bprendie/weazlbook/about.md

# About this We4zLbo0k

## Reader name
Your name or nickname

## If found
Please contact me using the details below.

## Contact
Email or phone (optional)

## Return instructions
Add a safe way to return this reader.

---

Edit this file in a text editor while the reader is connected over USB.
Only include details you want stored on the device. This file is erased by the duress code.
