bprendie/weazlbook/docs/WORK_PLAN.md

# R05 execution record

Preserve the R04 archive and extracted baseline unchanged. R05 is an engineering
prototype until the evidence register is closed; no hardware is known to be connected.

1. Reconcile R04, archive sources, establish tools and measurement gates.
2. Produce parametric enclosure, genuine part joints and fit coupons; check B-reps,
   meshes and interference against component allowances.
3. Implement an offline desktop reference reader and portable state, with hostile
   input and interrupted-save tests. Keep native firmware support separate.
4. Build an ESP-IDF hardware foundation and native PDF feasibility executable.
5. Export and inspect Kobra S1 0.4 mm ABS projects in the installed real slicer.
6. Record exact results, unsupported features and bench/print gates.

User confirmed Kobra S1, 0.4 mm nozzle, proposed ABS and preference for high speed.
ABS brand/flow limit is not yet specified. No automatic multicolor assumed.
