bprendie/weazlbook/WeazlBook_R04_approval.pdf

# weazlbook

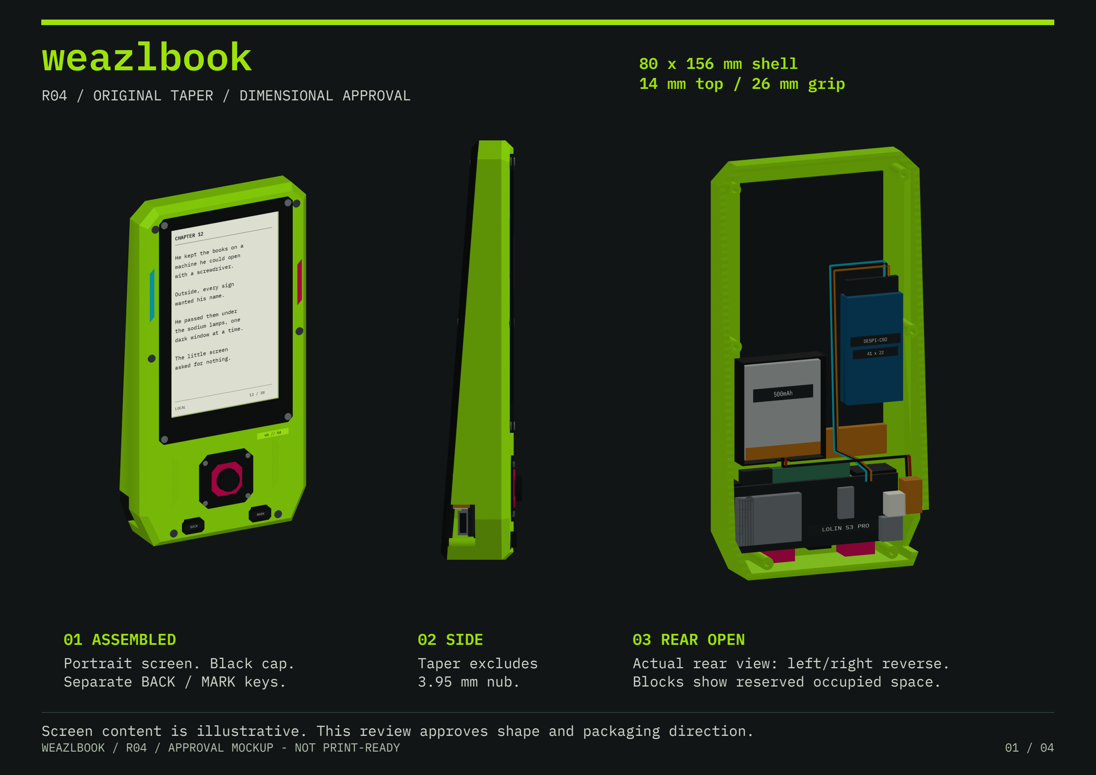
[picture p2: page 1]

R04 / ORIGINAL TAPER / DIMENSIONAL APPROVAL

WEAZLBOOK / R04 / APPROVAL MOCKUP - NOT PRINT-READY | 01 / 04

### 80 x 156 mm shell 14 mm top / 26 mm grip

### 01 ASSEMBLED

Portrait screen. Black cap. Separate BACK / MARK keys.

### 02 SIDE

Taper excludes
3.95 mm nub.

### 03 REAR OPEN

Actual rear view: left/right reverse. Blocks show reserved occupied space.

Screen content is illustrative. This review approves shape and packaging direction.

# SPACE FOR THE HARDWARE

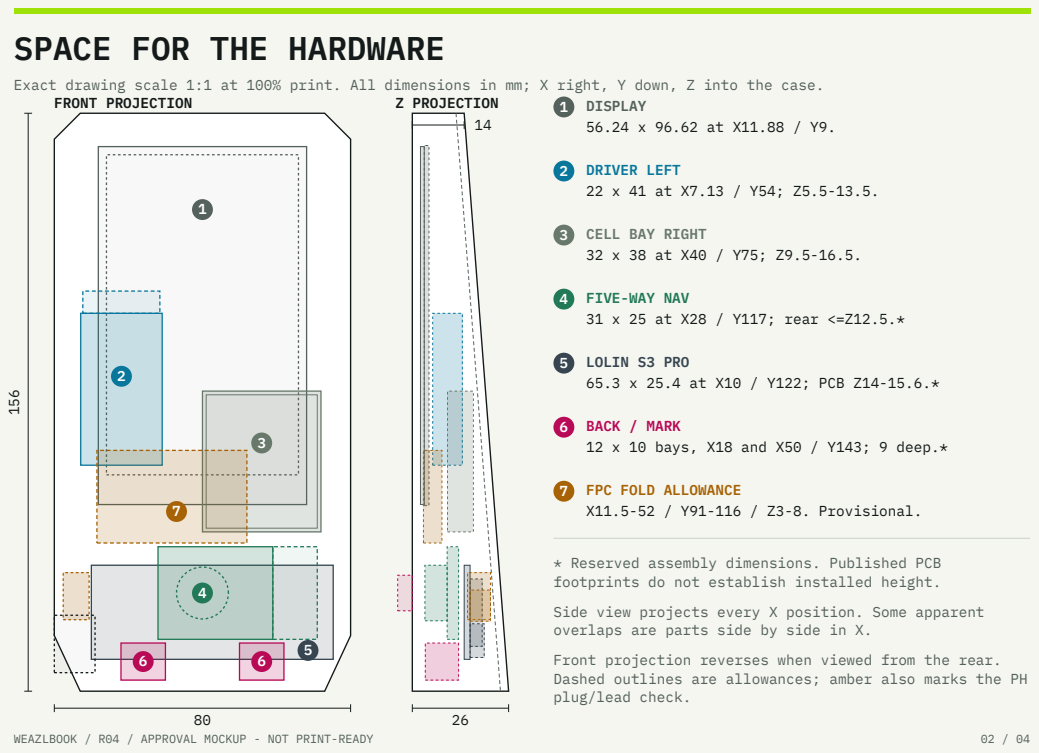
[picture p3: page 2]
FRONT PROJECTION; Z PROJECTION; 1 DISPLAY 56.24 x 96.62 at X11.88 / Y9.; 2 DRIVER LEFT 22 x 41 at X7.13 / Y54; Z5.5-13.5.; 5 LOLIN S3 PRO 65.3 x 25.4 at X10 / Y122; PCB Z14-15.6.*

Exact drawing scale 1:1 at 100% print. All dimensions in mm; X right, Y down, Z into the case.

3 CELL BAY RIGHT

4 FIVE-WAY NAV
31 x 25 at X28 / Y117; rear <=Z12.5.*

6 BACK / MARK
12 x 10 bays, X18 and X50 / Y143; 9 deep.*

7 FPC FOLD ALLOWANCE
X11.5-52 / Y91-116 / Z3-8. Provisional.

* Reserved assembly dimensions. Published PCB
footprints do not establish installed height.
Side view projects every X position. Some apparent
overlaps are parts side by side in X.
Front projection reverses when viewed from the rear.
Dashed outlines are allowances; amber also marks the PH
plug/lead check.

# PUBLISHED PARTS / RESERVED SPACE

Source links are attached to each part name. Full manufacturer geometry and measured assemblies remain distinct.

PART / SOURCE | PUBLISHED | R04 PACKAGING ALLOWANCE
1 DISPLAY GDEY0397T81P > (https://www.good-display.com/product/613.html) | 56.24 x 96.62 x 0.92 Tolerance: +/-0.2/0.2/0.1 | Glass Z2.2-3.22 includes upper tolerance. A separate insulation space sits behind.
2 DRIVER DESPI-C02 > (https://www.good-display.com/product/516.html) | 41 x 22 PCB. 24-pin FPC; 3.3 V SPI. | 8 mm full-depth space, Z5.5-13.5. 6 mm header projection; height unmeasured.
3 BATTERY Adafruit #1578 > (https://www.adafruit.com/product/1578) | 29 x 36 x 4.75 catalog. Protected 500 mAh cell. | Cell envelope 30 x 36 x 6; bay 32 x 38 x 7. Retain factory leads.
4 NAV MODULE EC Buying / Amazon > (https://www.amazon.com/dp/B0D8T4YQ3Y) | 31 x 25 PCB; holes 3 dia. Stem location photo-derived. | Rear limit Z12.5 is provisional. 12 mm for side header and wiring.
5 MAINBOARD LOLIN S3 PRO > (https://www.wemos.cc/en/latest/s3/s3_pro.html) | 65.3 x 25.4 PCB. USB + microSD onboard. | PCB Z14-15.6; local connectors to Z21.1. Port/plug shapes are simplified allowances.
6 TWO TACTILES Omron B3F-1000 > (https://components.omron.com/us-en/datasheet_pdf/A070-E1.pdf) | 6 x 6 x 4.3 each. 7.7 lead-inclusive width. | Each installed bay 12 x 10 x 9. Printed keys and guides above the switches.
CAP + ADAPTER Sprintek 109-00060 > (https://store.sprintek.com/category/flexpoint-pointing-stick) | Fits 2.4 mm square or 3.15 mm round Sprintek stem. | Shown cap dia.9.6 x 2.3 is provisional. Keep dia.14 sweep; measure adapter/socket.

FPC: 33.66 mm published tail reach. R2 fold and seated-tip Y93 are proposed; the driver carrier
needs insertion-depth adjustment.
PH/JST region reaches Z21.1. Only about 0.2-0.6 mm nominal rear-cover clearance remains locally; this is a measured-fit gate.
Amber blocks are FPC and plug/lead check space. Colored strands show harness corridors, not a final wire count or pinout.
INSIDE COVER

# ONE-TO-ONE PAPER CHECK

Approve hand spacing and profile. The outline is not a drill, cut or production template.
FRONT / 1:1 | SIDE / 1:1

READING AREA
51.84 x 86.40

14

26

3.95
nub

156

80

FOUR MEASUREMENTS TO CLOSE

01 / DISPLAY ASSEMBLY
Delivered GDEY panel suffix; adapter height, slot position and insertion depth; gentle FPC fold with strain relief.

02 / NAV + CAP
Stem and cap socket, installed depth, lateral sweep and select travel. Keep the carrier replaceable.

03 / USB + BATTERY PLUG
Actual housings, cable boot and lead turn together. The left opening is an open recess; the PH check volume is provisional.

04 / CELL + SERVICE
Protected cell thickness and wire exit; rear-cover clearance and rear-only microSD access. Retain factory battery leads.

Print at 100% / Actual Size.
Disable Fit to Page.
Verify this bar measures 50 mm.

50 mm

Short 28 AWG device harness.
No measured runtime or working firmware is represented by this mockup.
