bprendie/weazlbook/artifacts/cad/R05-engineering-review.pdf

# WEAZLBOOK / R05

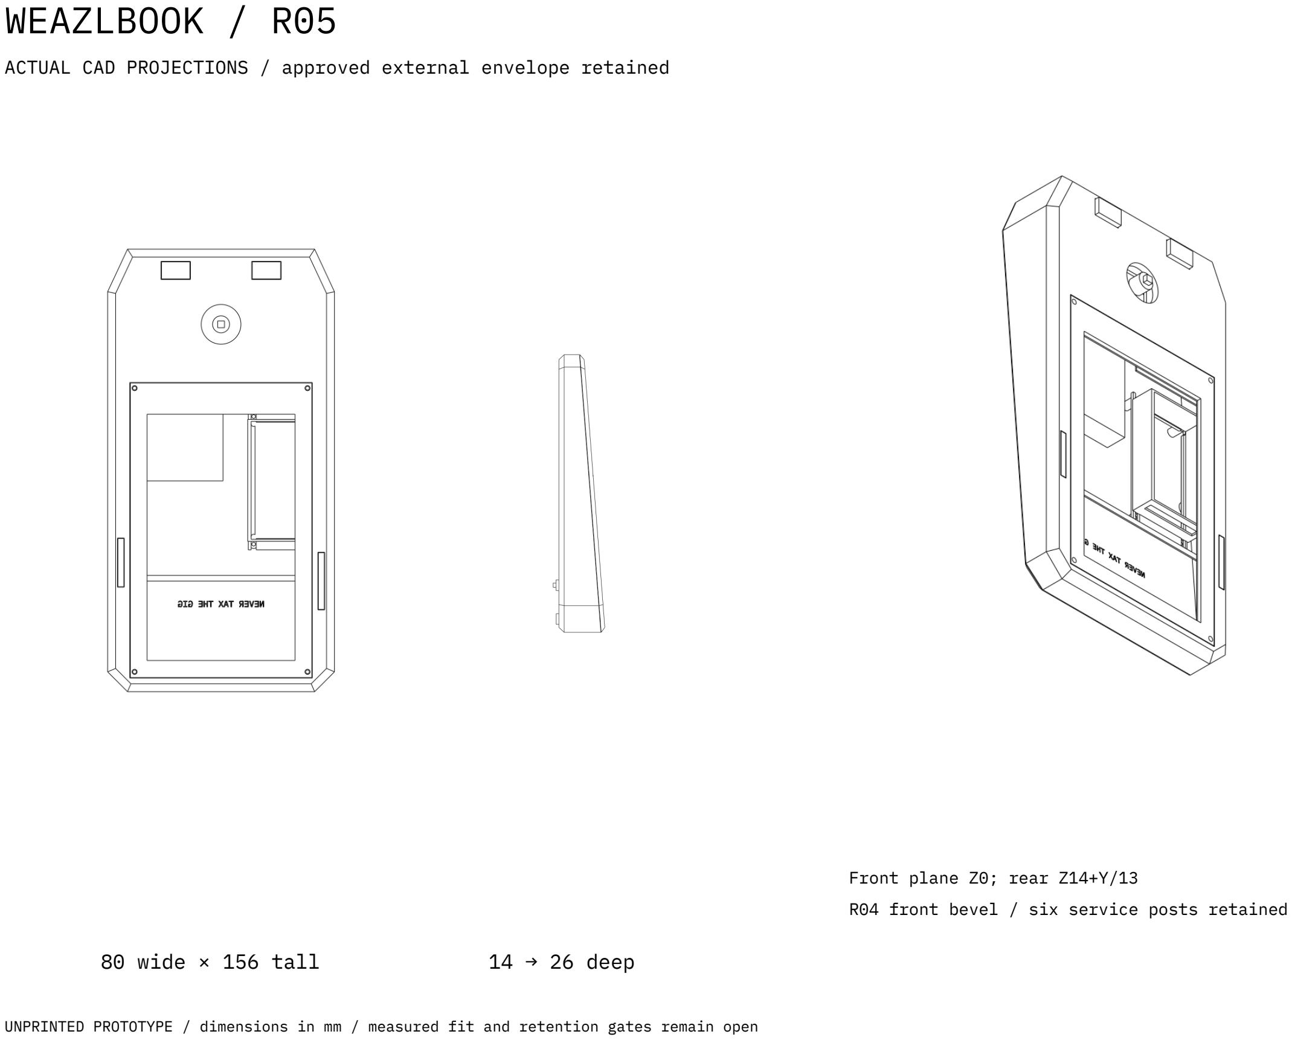
[picture p4: page 1]

ACTUAL CAD PROJECTIONS / approved external envelope retained

UNPRINTED PROTOTYPE / dimensions in mm / measured fit and retention gates remain open

80 wide × 156 tall | 14 → 26 deep

Front plane Z0; rear Z14+Y/13
R04 front bevel / six service posts retained

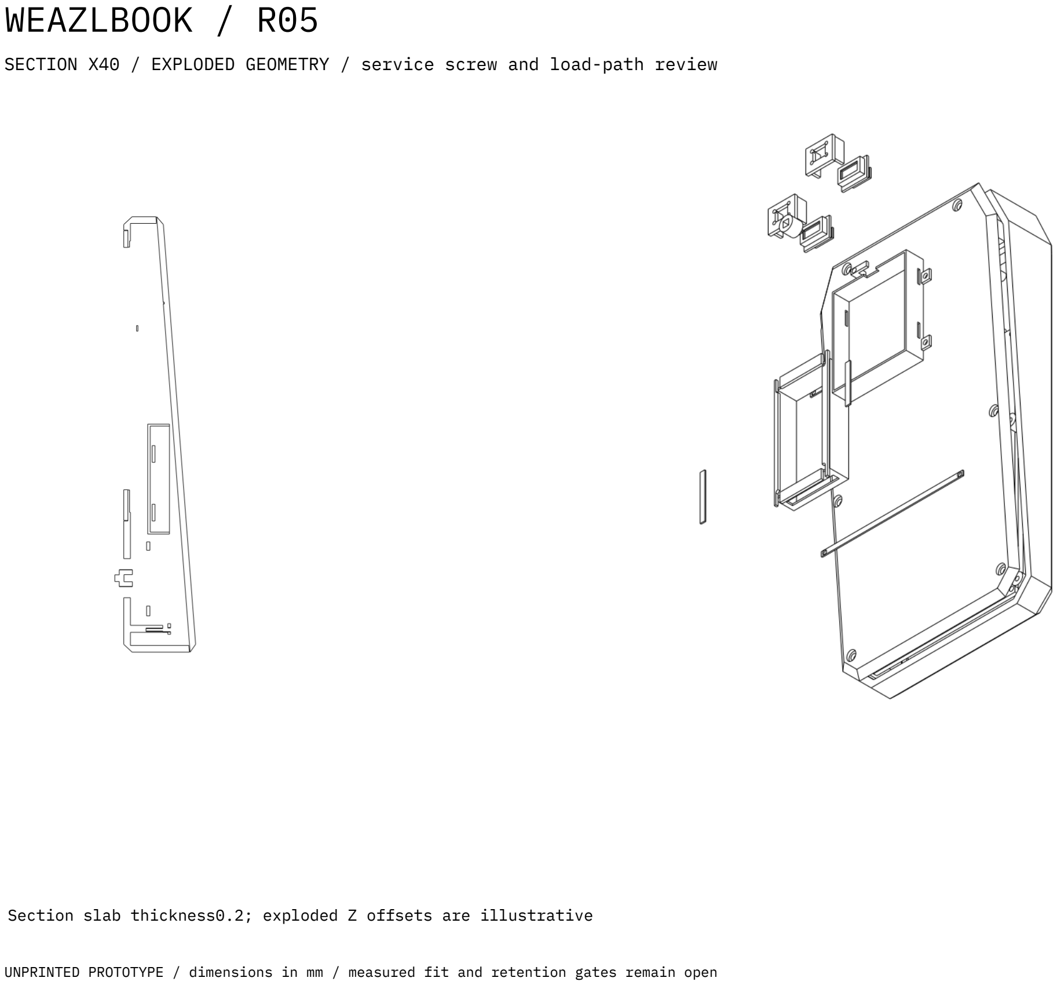
[picture p5: page 2]

SECTION X40 / EXPLODED GEOMETRY / service screw and load-path review

Section slab thickness0.2; exploded Z offsets are illustrative

DIMENSION AND CLEARANCE LEDGER / values computed from R05 sources

Shell outline | 80 × 156; outer octagon preserved
Rear envelope | 14 at Y0;26 at Y156
Glass pocket | 56.84 × 97.22; starts Z2.1
Glass allowance | 56.24 × 96.62 × 1.02
Battery tray rim | Z16.4; nominal plane gap1.115 at Y74.3
Nav rear to PCB | Z12.5 → Z14 =1.5
FPC loop assumption | R2;33.66 length;tipY93;apexY114.998
FPC apex to nav | Y117-114.998 =2.002; bend NOT approved
Battery plug turn | X3.2-2.4 =0.8; real lead turn unresolved
Mainboard clamps | 0.2 nominal shim gap above PCB
Service pilots | diameter1.7;depth7;M2x8 candidate
Key guide / stop | 0.2 per side;0.4 travel;carrier retention OPEN
Part collision volumes | 0 intersections >0.001 mm3
Component block collisions | 0 intersections >0.001 mm3

LOAD PATHS / ASSEMBLY ACCESS / PHYSICAL GATES

Thumb → nav PCB bearing edges → front carrier → columns → chin/frame.

Glass and battery are excluded from the thumb load path.

Display → measured compliant gasket/insulation → bezel/front ledge + bridges.

Battery → tray floor and loose fabric strap → two shell-side tray lugs.

Mainboard → three R04 underlap supports; removable edge clamps retain it.

Rear cover → six M2 service posts. Check engagement and blind-hole floor.

Driver carrier attaches to cover: opening/FPC access must be demonstrated.

Driver Y slots allow ±3 adjustment; seated tail tip is not connector mouth.

Key carrier retention and VBUS sensor mounting remain OPEN CAD gates.

USB cable and PH plug must be inserted simultaneously for fit verification.

No physical battery life, RF, USB-copy or drop-test result is asserted.
