bprendie/weazlbook/artifacts/alice-preview.png

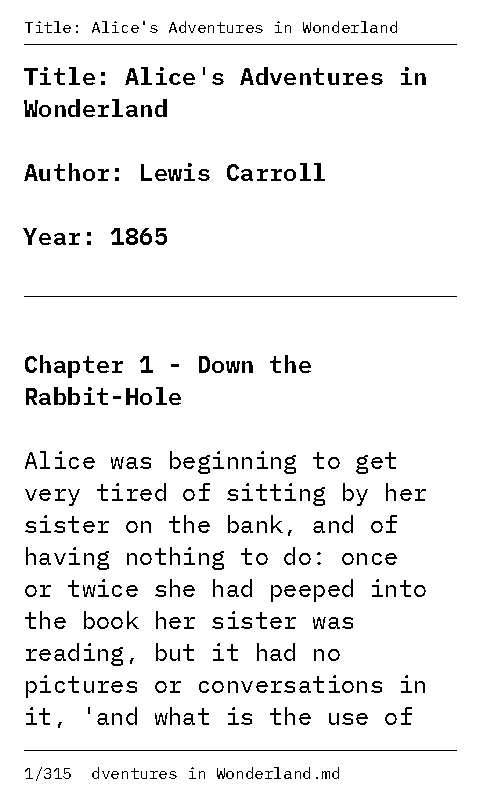
artifacts/alice-preview.png
