bprendie/weazlbook/artifacts/cad/views/exploded.png

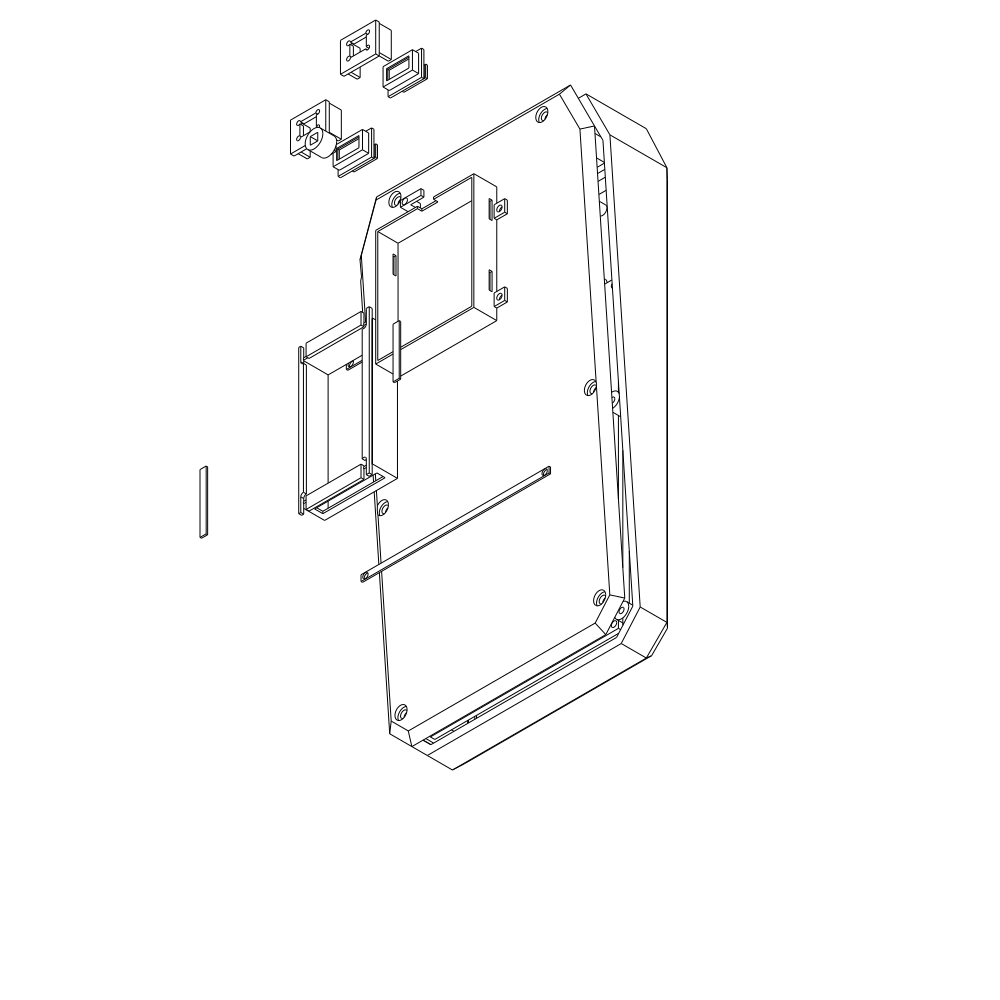
artifacts/cad/views/exploded.png
