bprendie/weazlbook/artifacts/cad/views/front.png

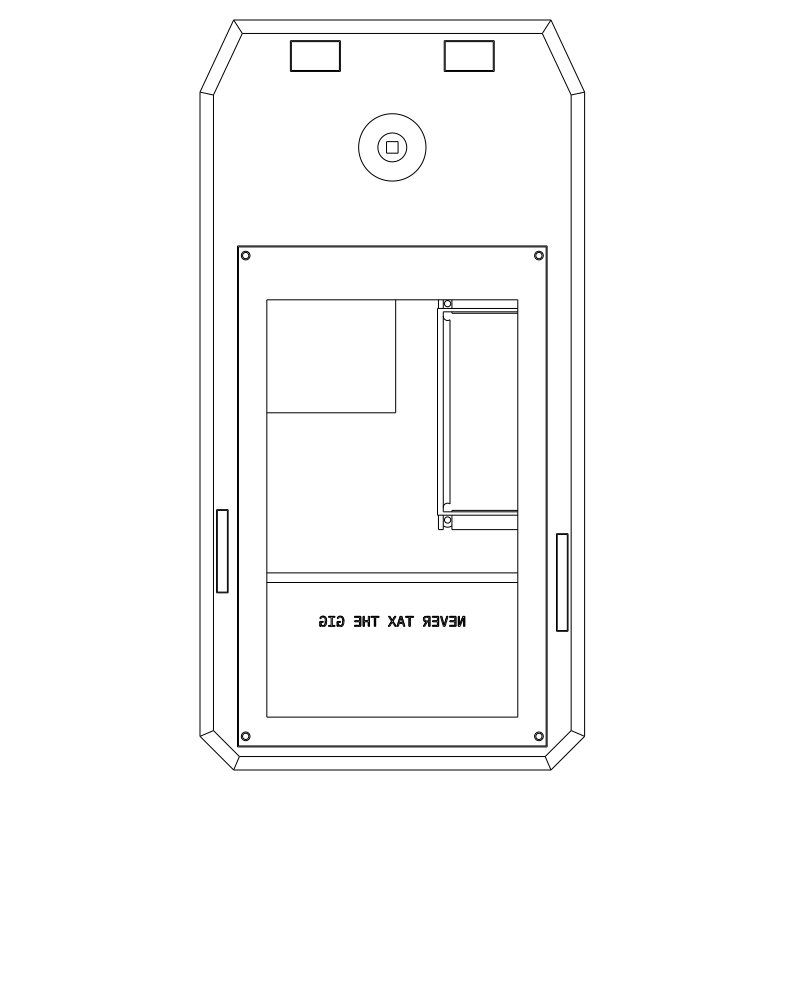
artifacts/cad/views/front.png
