bprendie/weazlbook/artifacts/cad/views/isometric.png

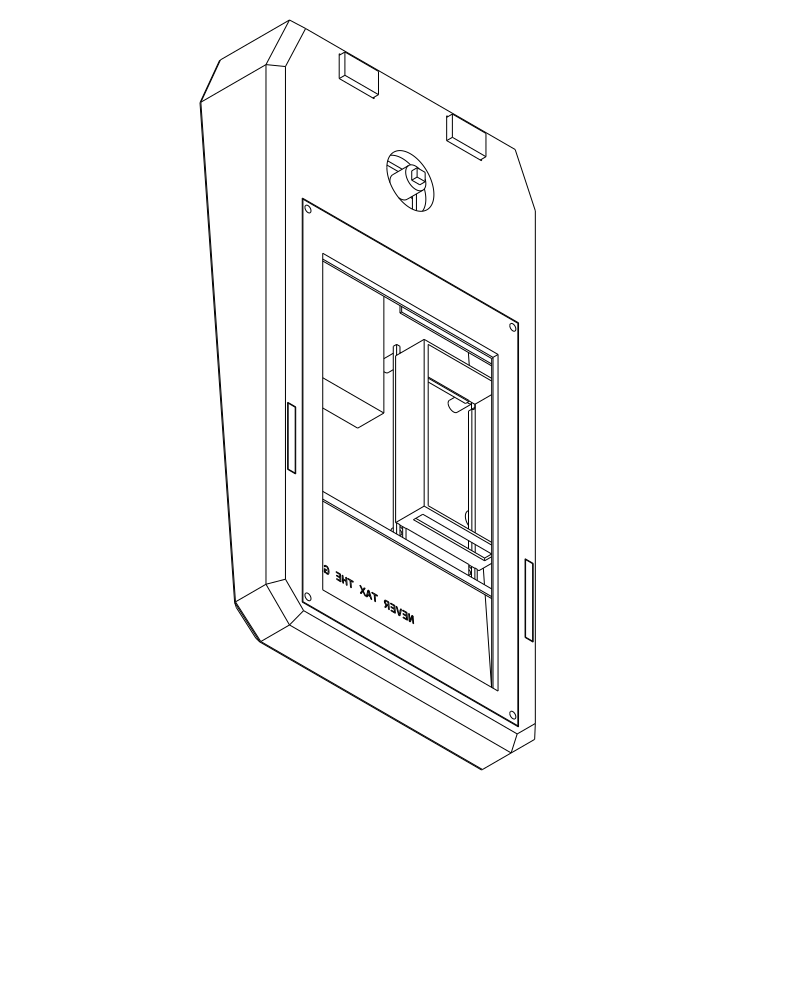
artifacts/cad/views/isometric.png
