bprendie/weazlbook/artifacts/cad/views/section-x40.png

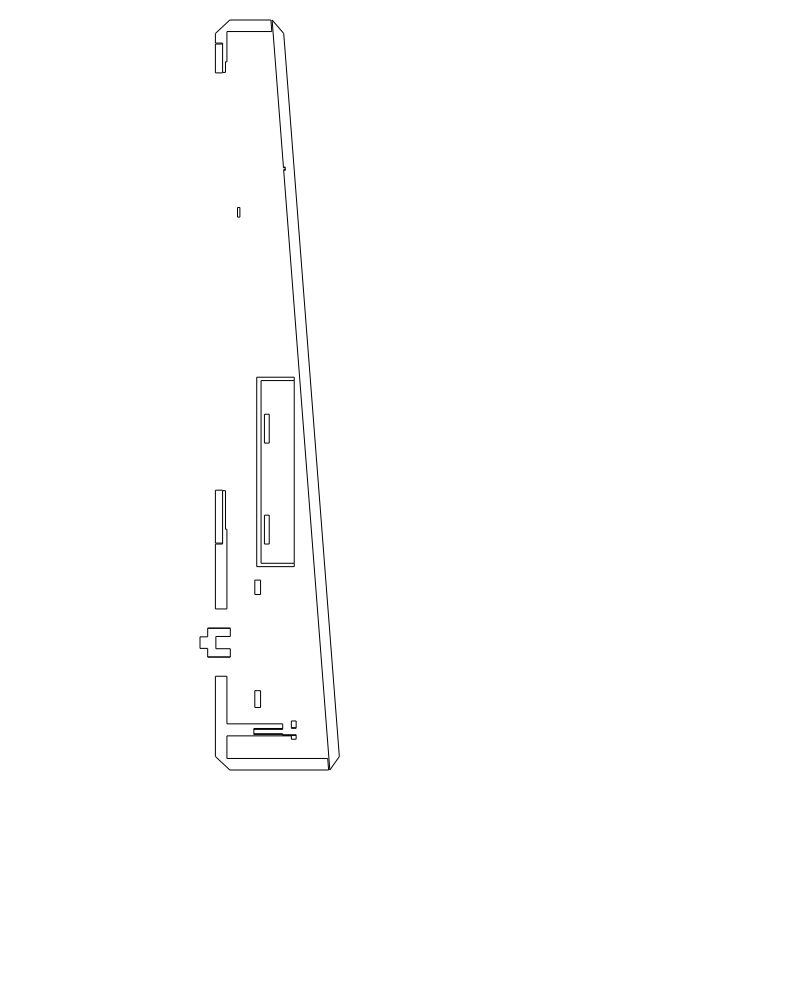
artifacts/cad/views/section-x40.png
