bprendie/weazlbook/artifacts/markdown-formatting.png

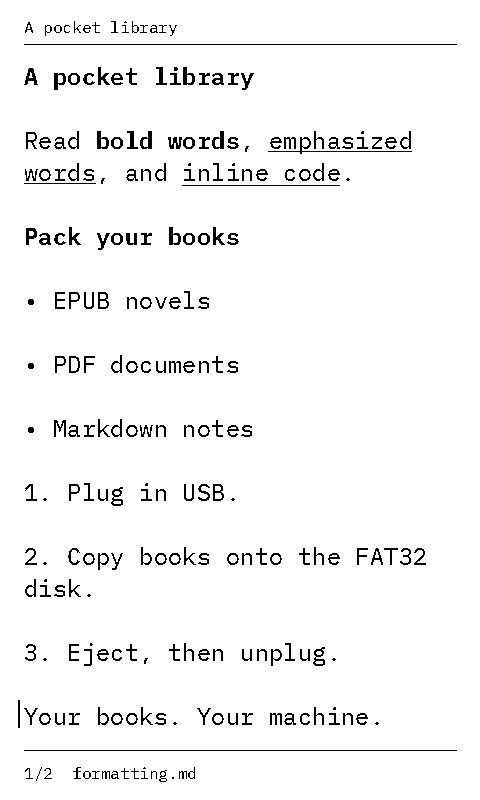
artifacts/markdown-formatting.png
