bprendie/weazlbook/artifacts/plates/01_coupons-placement.png

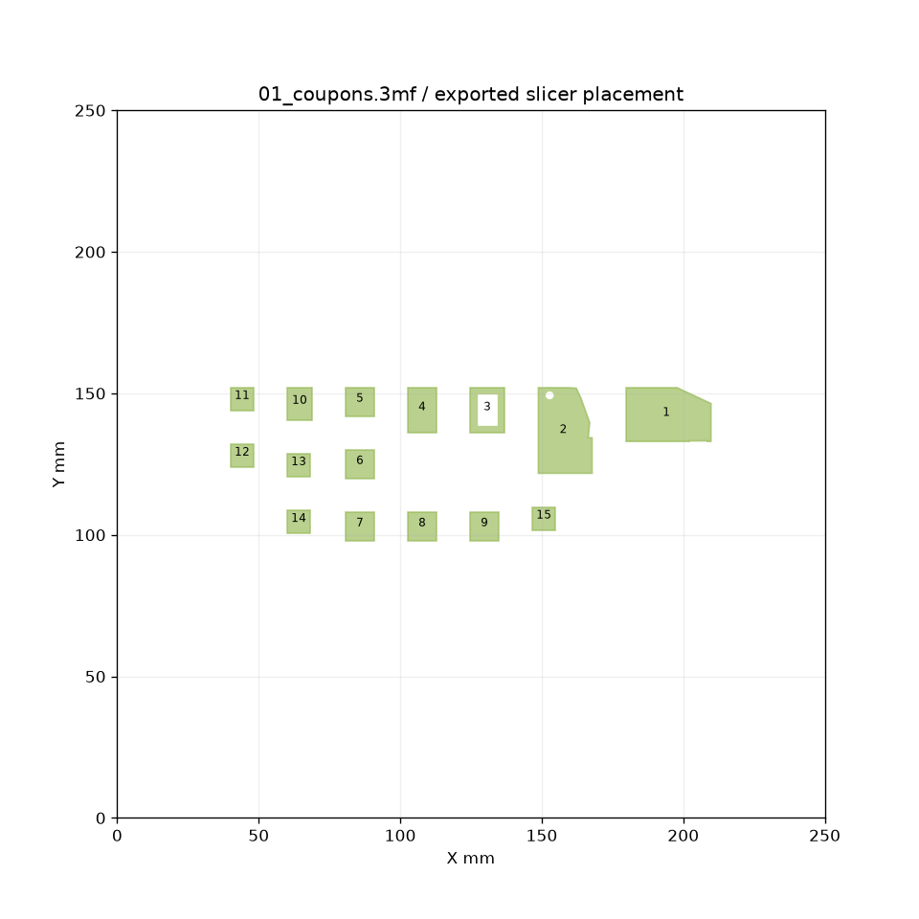
artifacts/plates/01_coupons-placement.png
