bprendie/weazlbook/artifacts/plates/acid_green-placement.png

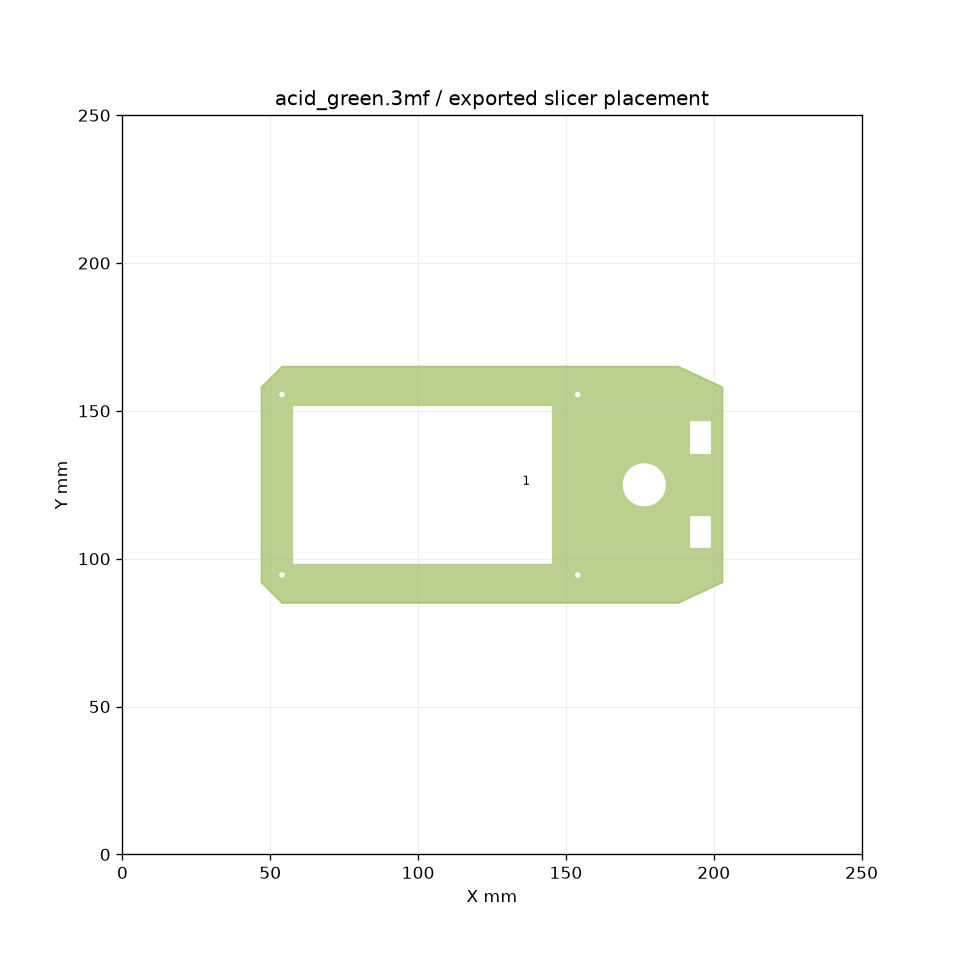
artifacts/plates/acid_green-placement.png
