bprendie/weazlbook/artifacts/plates/black-placement.png

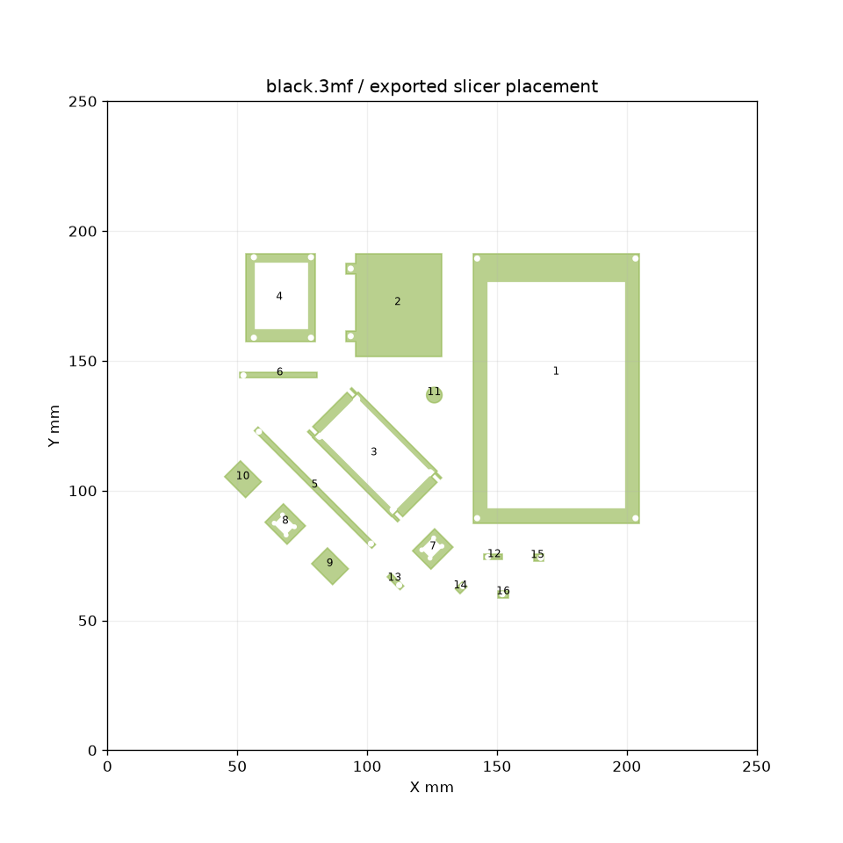
artifacts/plates/black-placement.png
