bprendie/weazlbook/artifacts/plates/cyan-placement.png

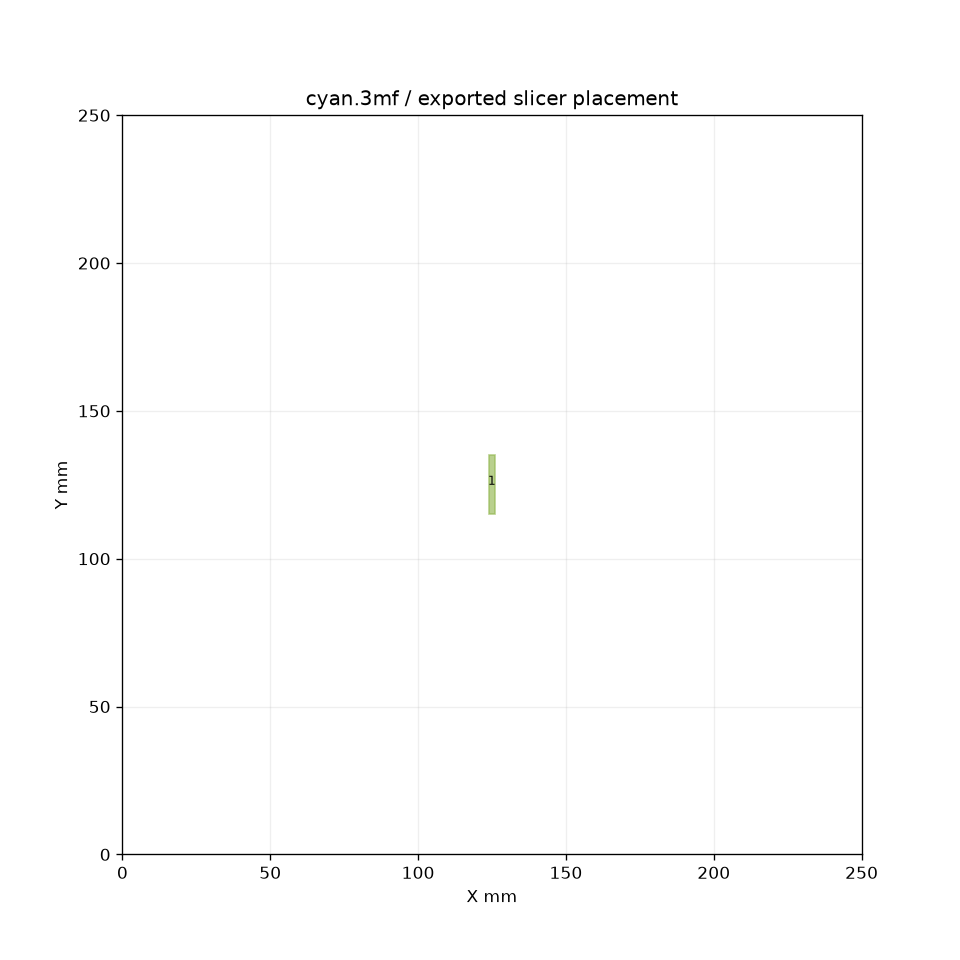
artifacts/plates/cyan-placement.png
