bprendie/weazlbook/artifacts/reader-preview.png

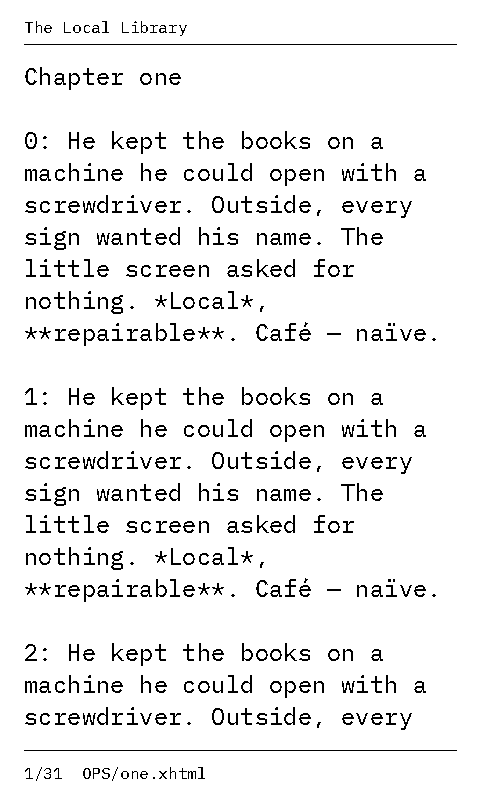
artifacts/reader-preview.png
