bprendie/weazlbook/artifacts/simulator-alice.png

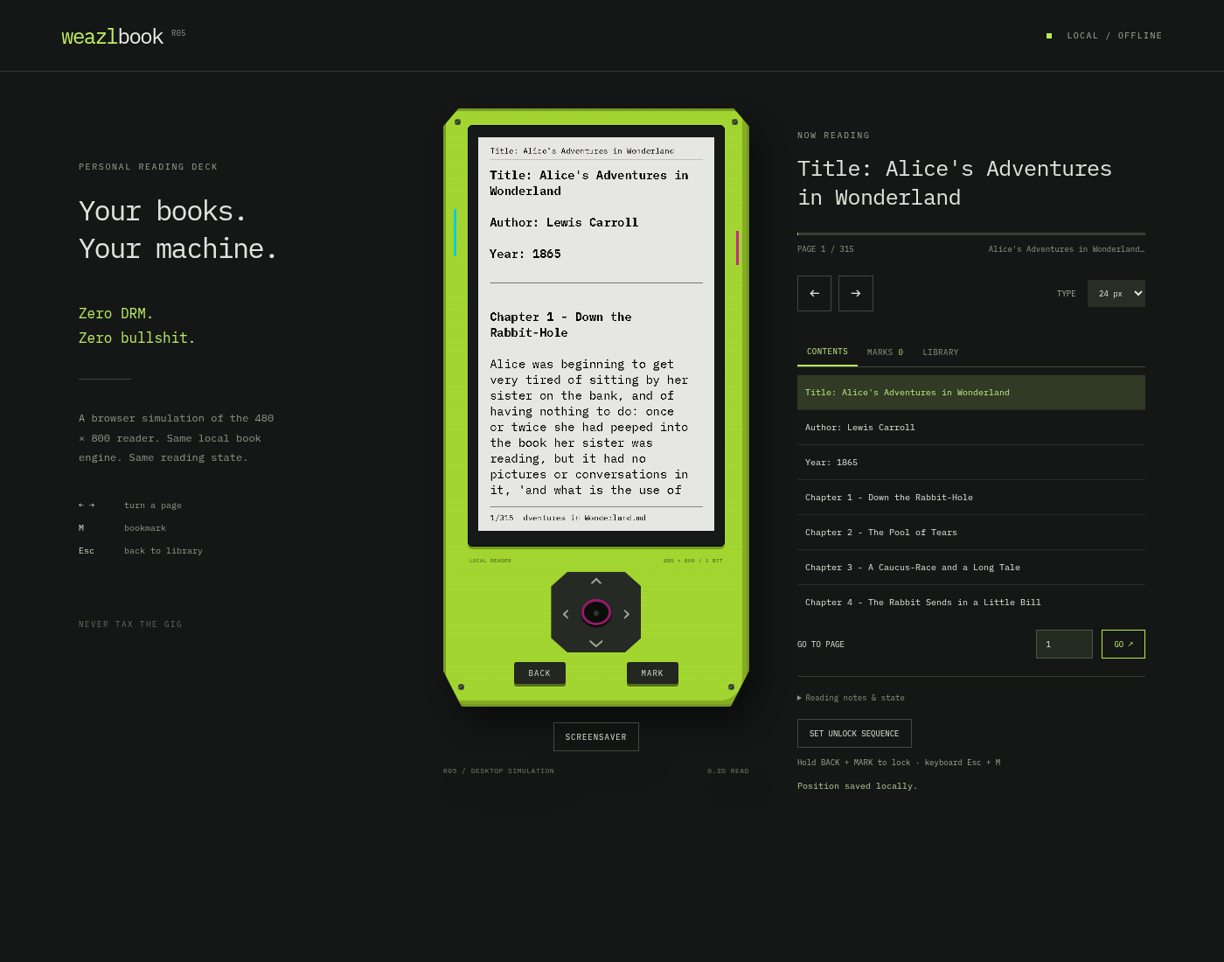
artifacts/simulator-alice.png
