bprendie/weazlbook/artifacts/simulator-desktop.png

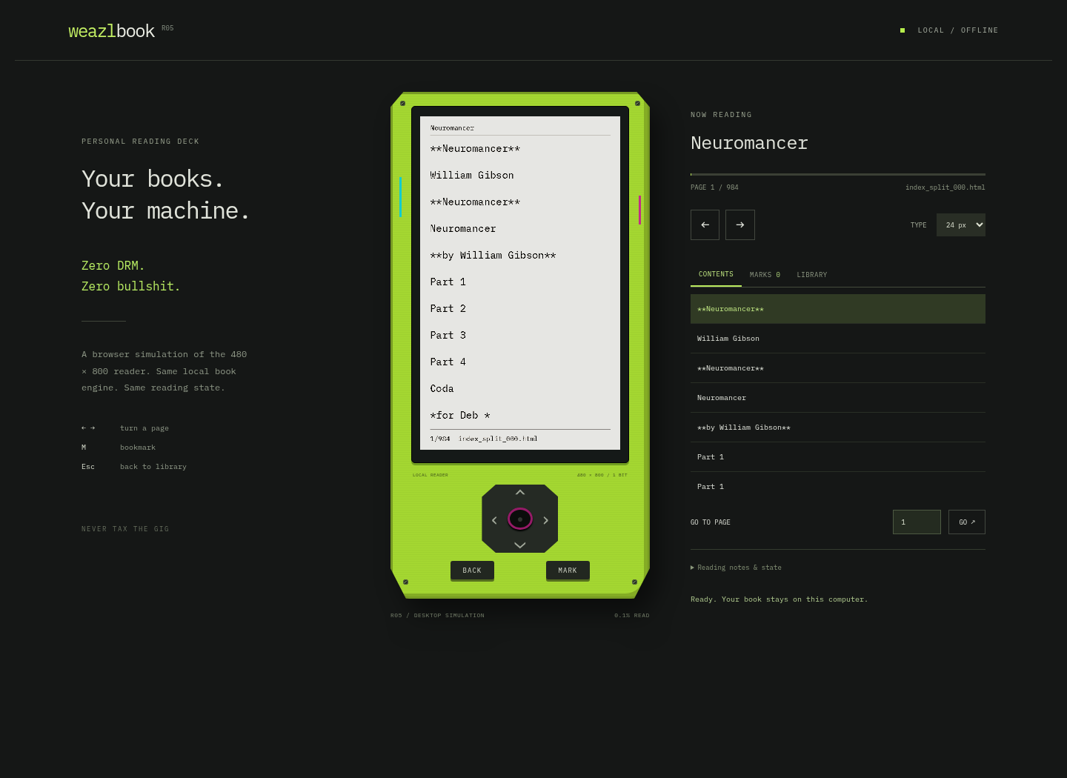
artifacts/simulator-desktop.png
