bprendie/weazlbook/artifacts/simulator-main-menu-mobile.png

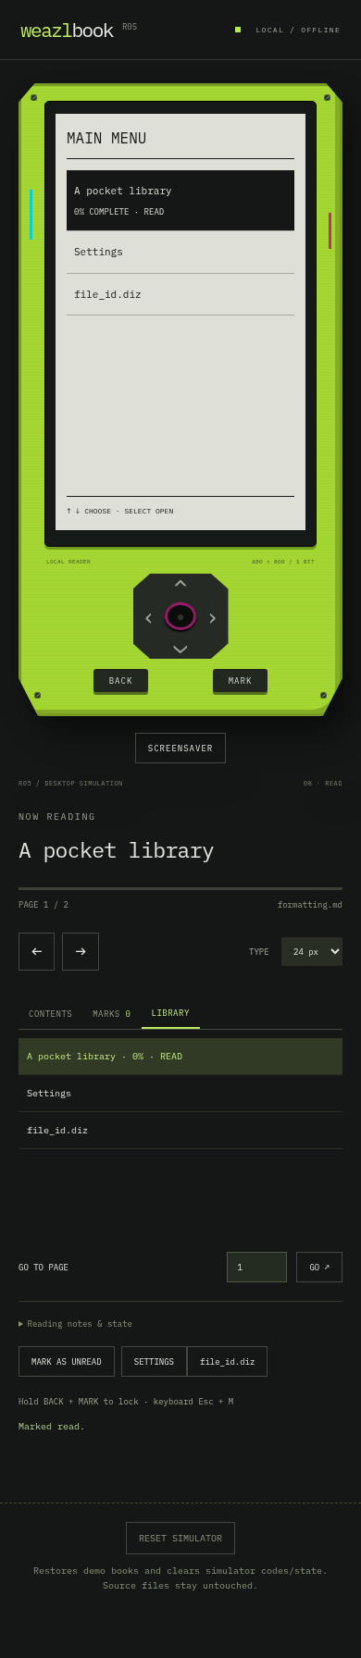
artifacts/simulator-main-menu-mobile.png
