bprendie/weazlbook/artifacts/simulator-mobile.png

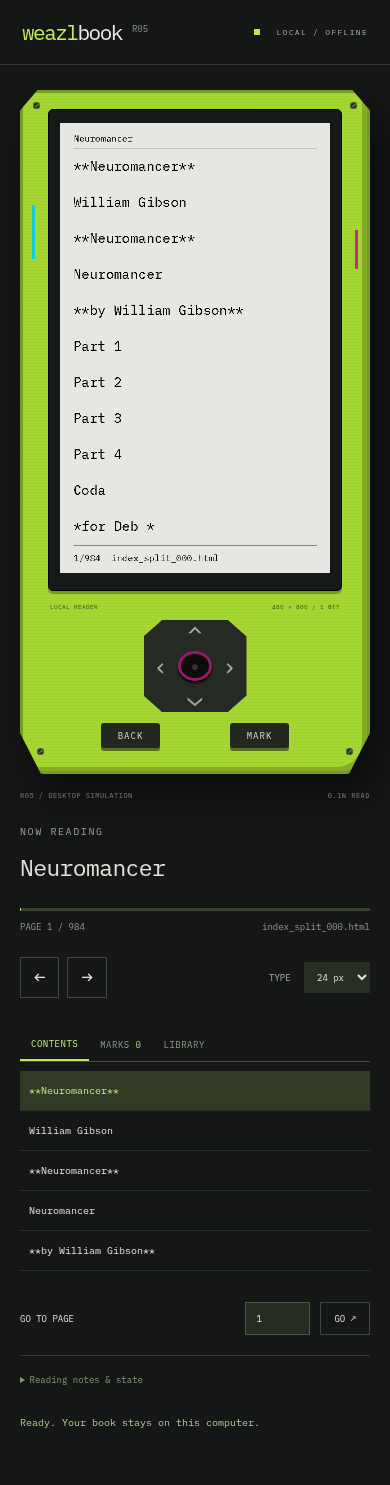
artifacts/simulator-mobile.png
