bprendie/weazlbook/artifacts/simulator-screensaver-mobile.png

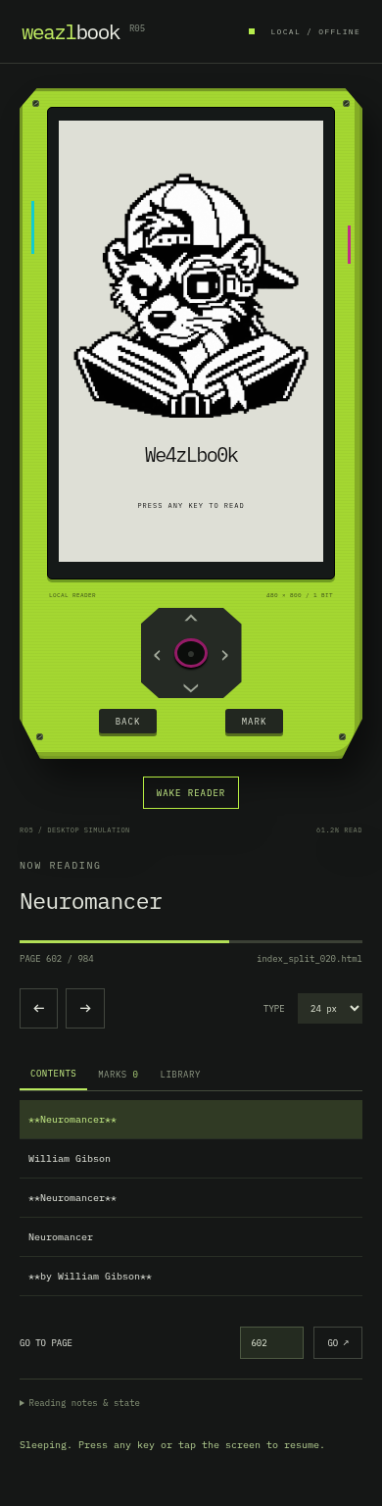
artifacts/simulator-screensaver-mobile.png
