bprendie/weazlbook/artifacts/simulator-settings.png

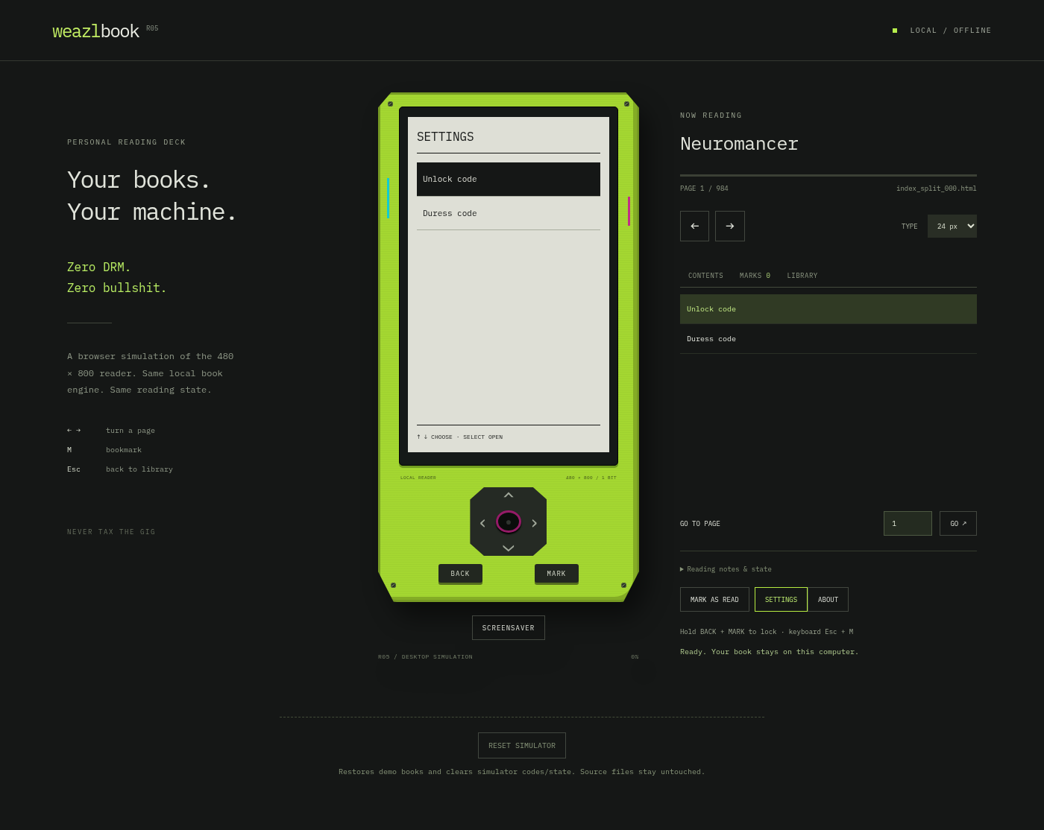
artifacts/simulator-settings.png
