bprendie/weazlbook/baseline/weazlbook_mockup_r04/render/front.png

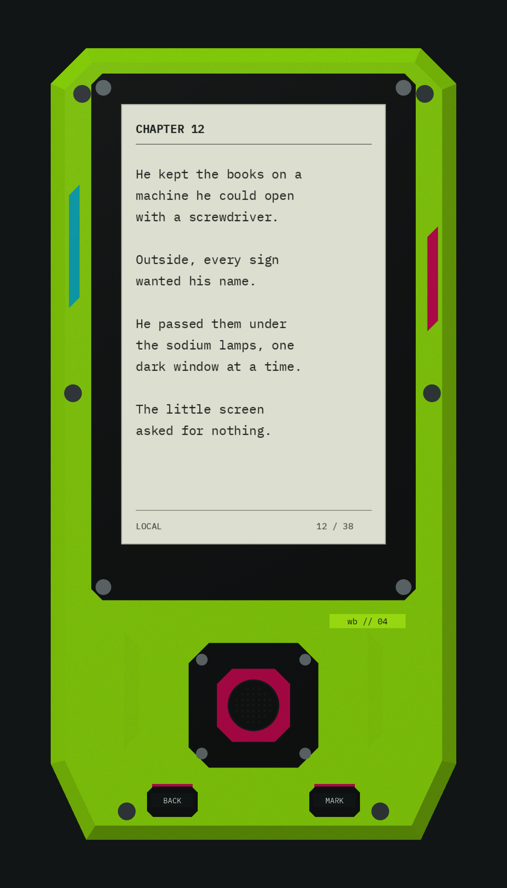
baseline/weazlbook_mockup_r04/render/front.png
