bprendie/weazlbook/baseline/weazlbook_mockup_r04/render/inside_cover.png

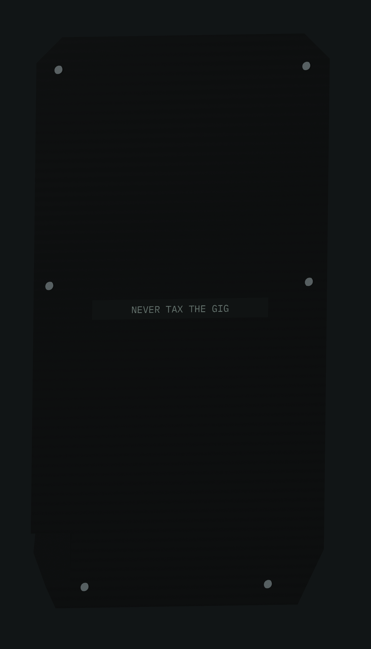
baseline/weazlbook_mockup_r04/render/inside_cover.png
