bprendie/weazlbook/baseline/weazlbook_mockup_r04/render/left_profile.png

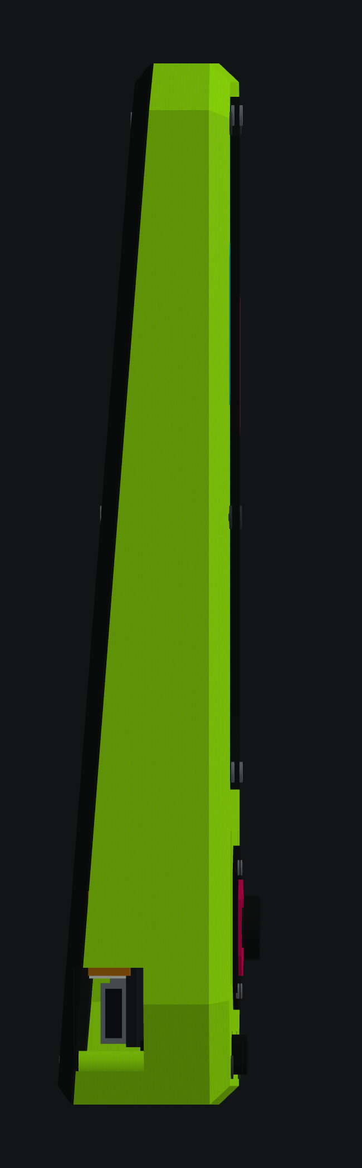
baseline/weazlbook_mockup_r04/render/left_profile.png
