bprendie/weazlbook/baseline/weazlbook_mockup_r04/render/rear_open.png

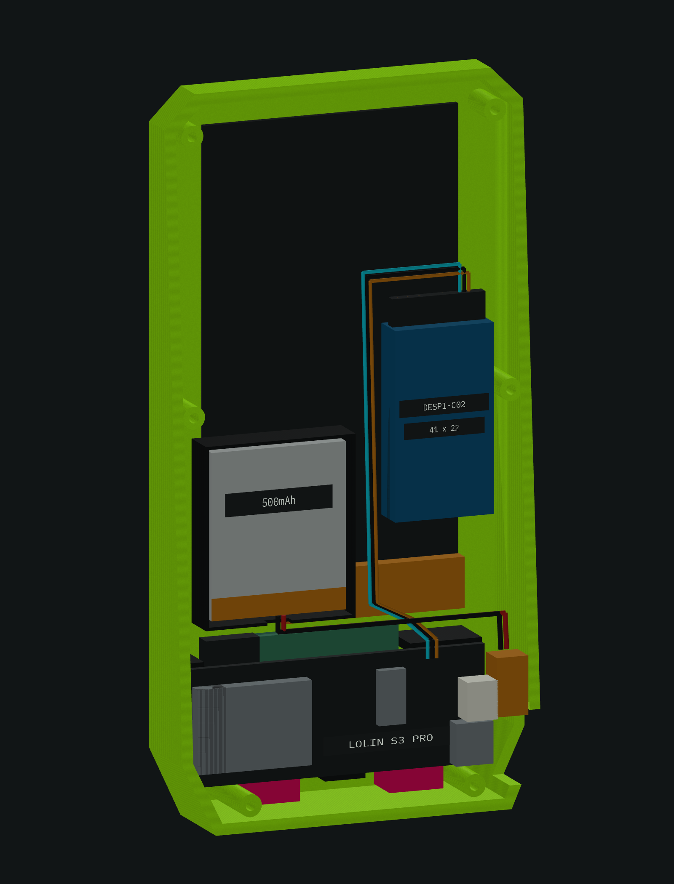
baseline/weazlbook_mockup_r04/render/rear_open.png
