bprendie/weazlbook/baseline/weazlbook_mockup_r04/render/rear_orthographic.png

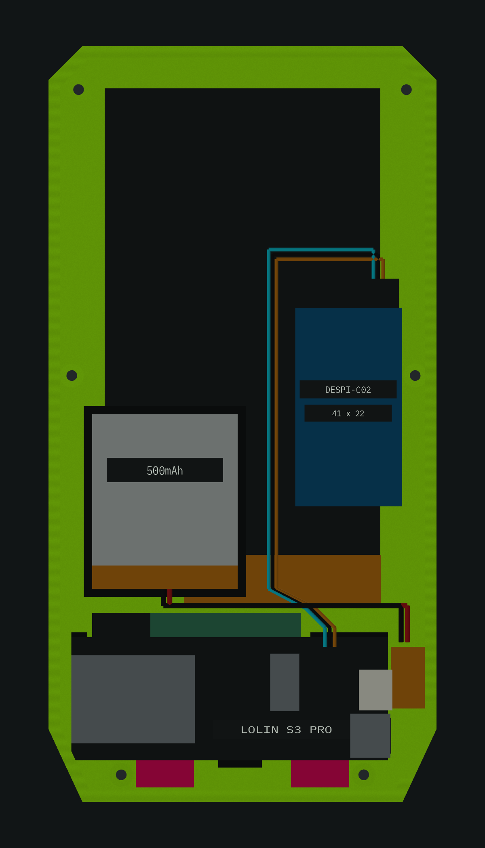
baseline/weazlbook_mockup_r04/render/rear_orthographic.png
