bprendie/weazlbook/baseline/weazlbook_mockup_r04/render/screen_sample.png

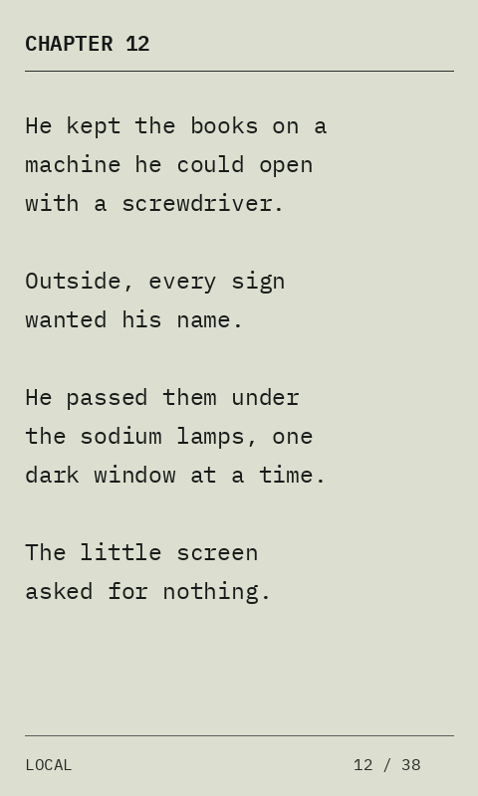
baseline/weazlbook_mockup_r04/render/screen_sample.png
