bprendie/weazlbook/downloads/s3_pro_schematic.png

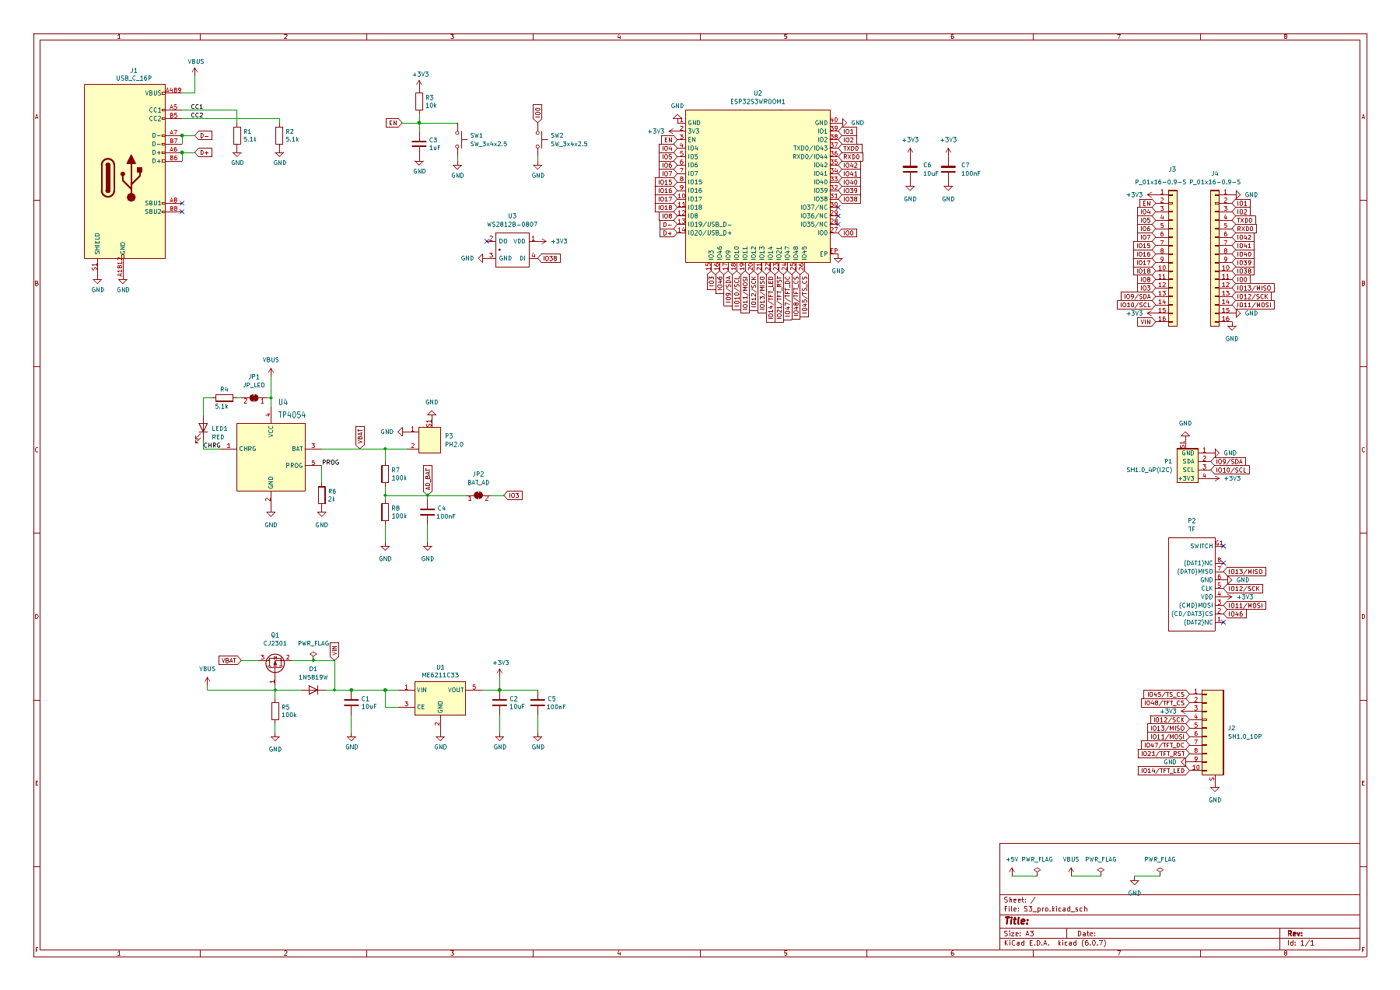
downloads/s3_pro_schematic.png
