bprendie/weazlbook/reader/web_assets/screensaver.png

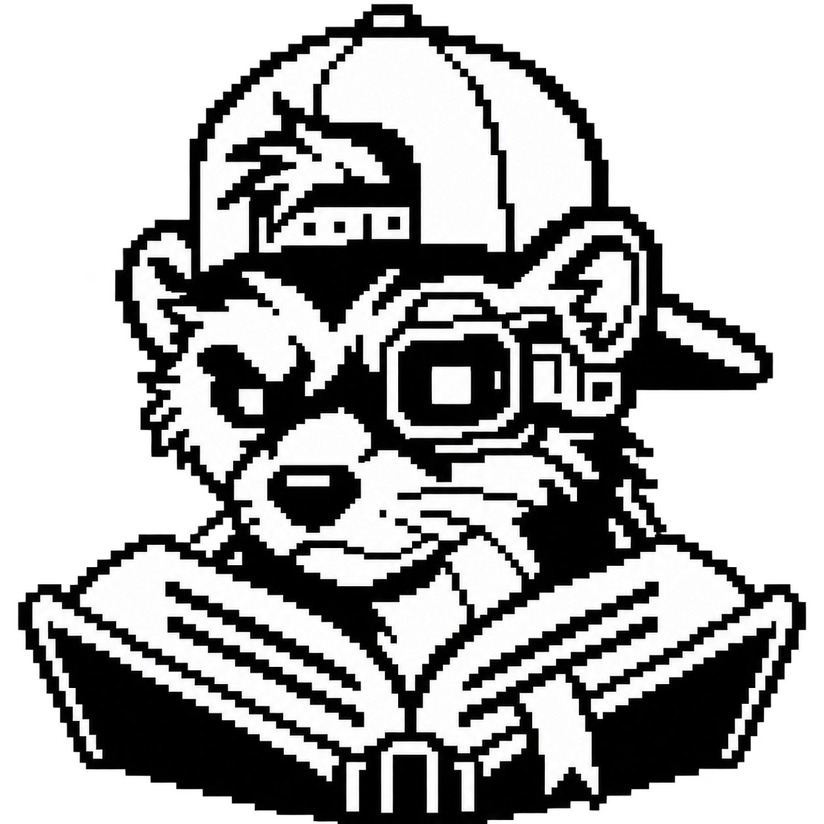
reader/web_assets/screensaver.png
