bprendie/weazlbook/weazlbook_color.png

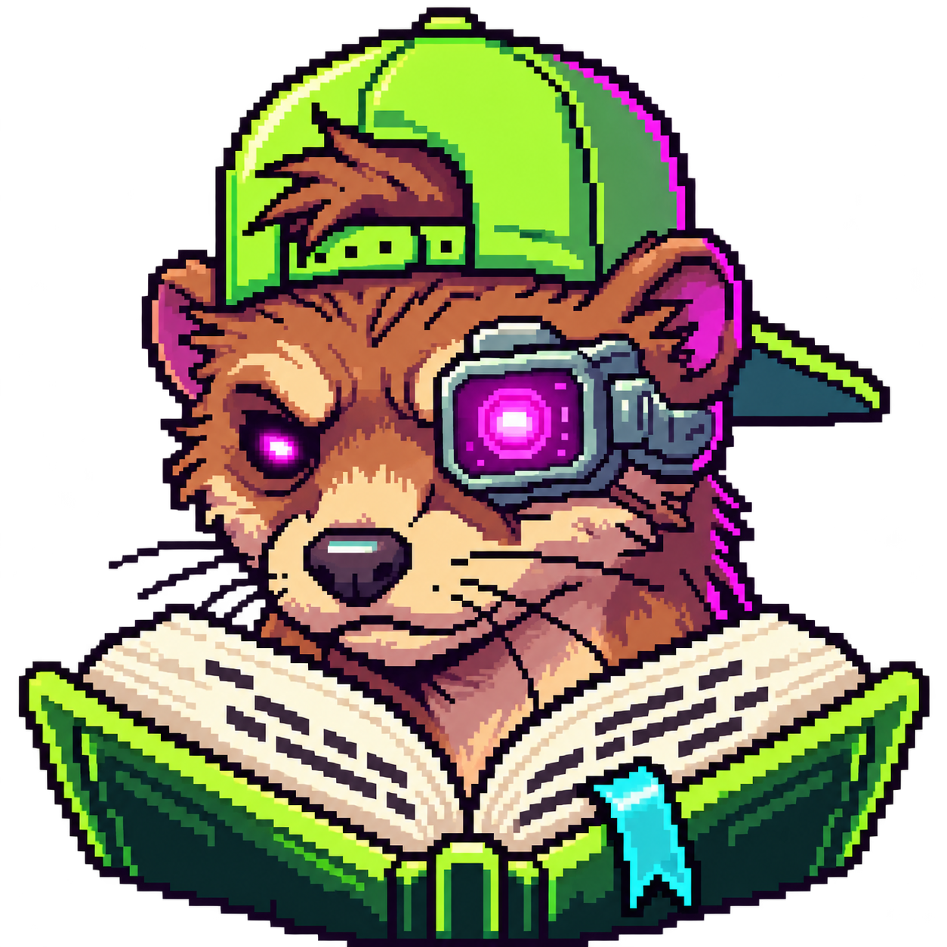
weazlbook_color.png
