bprendie/weazlbook/artifacts/cad/assembly.step

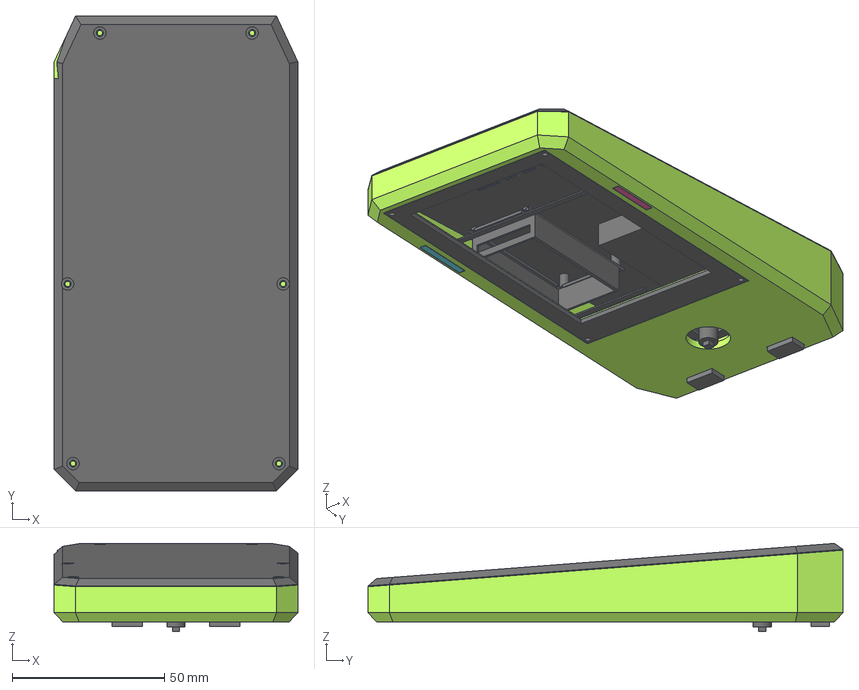
[picture p32: CAD file, 2026-10-19]
artifacts/cad/assembly.step
80.0 x 156.0 x 29.0 mm
mainboard_clamp_0
mainboard_clamp_1
mainboard_clamp_2
service_cover
bezel
nav_carrier
nav_retainer_0
nav_retainer_1
display_bridge_0
display_bridge_1
driver_carrier_adjustable
battery_tray
back_key
back_tpu_face
back_carrier
mark_key
mark_tpu_face
mark_carrier
cap_adapter_provisional
cyan_insert
magenta_insert
