bprendie/weazlbook/artifacts/cad/step/mainboard_clamp_1.step

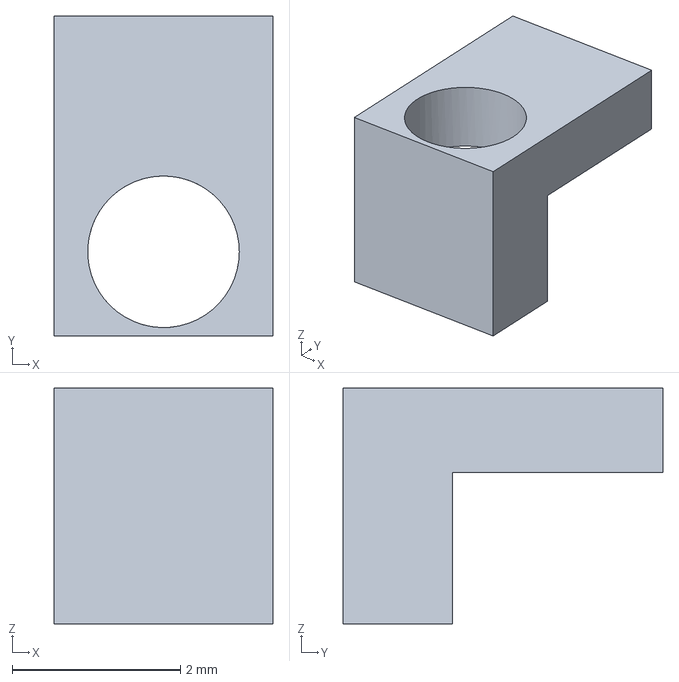
[picture p33: CAD file, 2026-10-19]
artifacts/cad/step/mainboard_clamp_1.step
2.60 x 3.80 x 2.80 mm
