bprendie/weazlbook/artifacts/cad/coupons/nav_square_2.55mm.stl

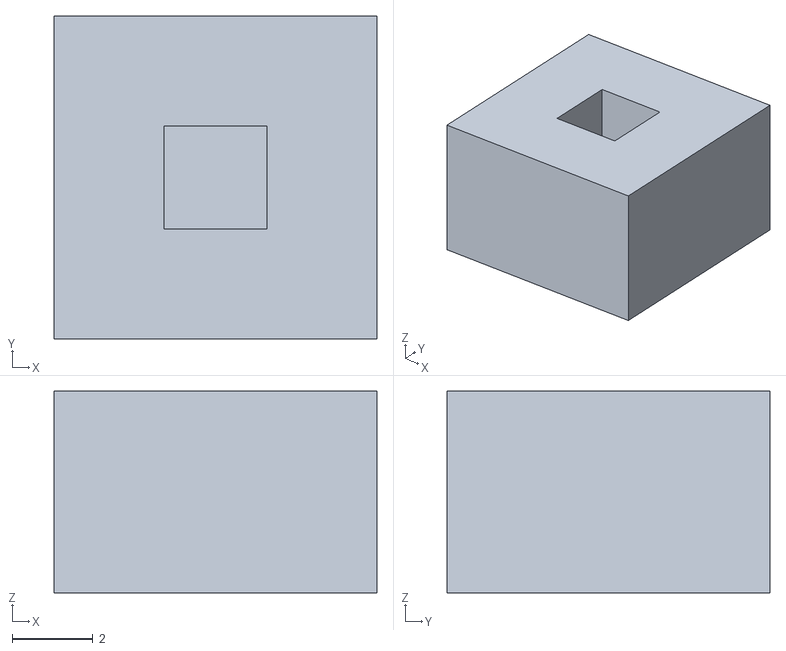
[picture p35: CAD file, 2026-10-19]
artifacts/cad/coupons/nav_square_2.55mm.stl
8.00 x 8.00 x 5.00
