bprendie/weazlbook/artifacts/cad/reference_envelopes.step

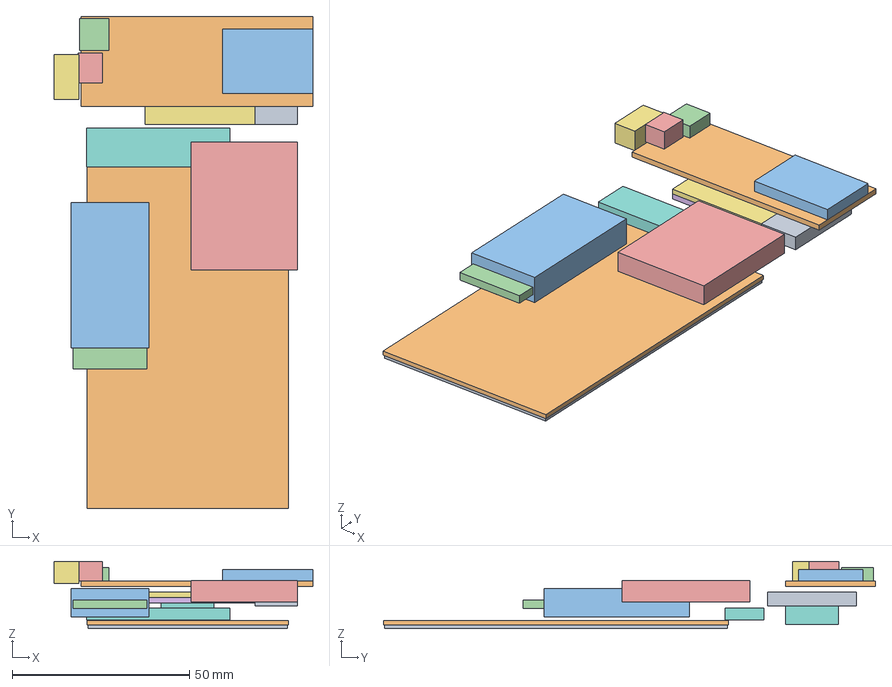
[picture p36: CAD file, 2026-10-19]
artifacts/cad/reference_envelopes.step
72.9 x 138.7 x 18.9 mm
glass
display_backing
driver
driver_header
cell
nav_pcb
nav_rear
nav_mechanism
nav_header
mainboard_pcb
module
usb
battery_socket
battery_plug
ph_check
fpc_turn
