bprendie/weazlbook/artifacts/cad/step/cap_adapter_provisional.step

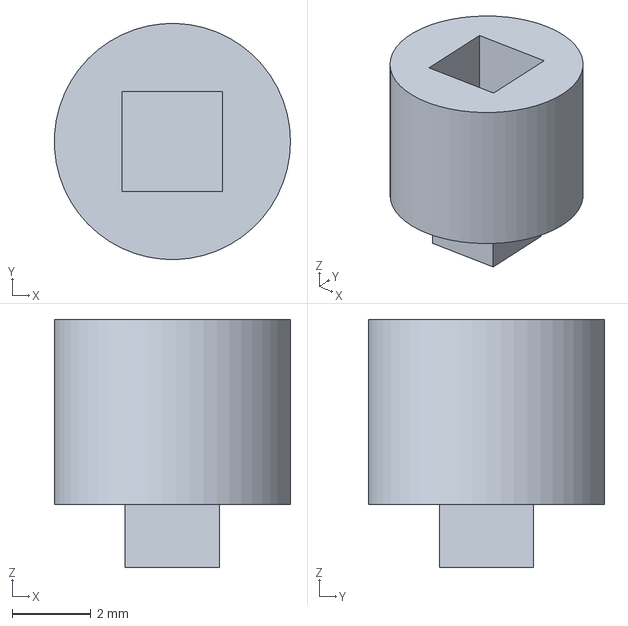
[picture p37: CAD file, 2026-10-19]
artifacts/cad/step/cap_adapter_provisional.step
5.99 x 6.00 x 6.30 mm
