bprendie/weazlbook/artifacts/plates/magenta.3mf

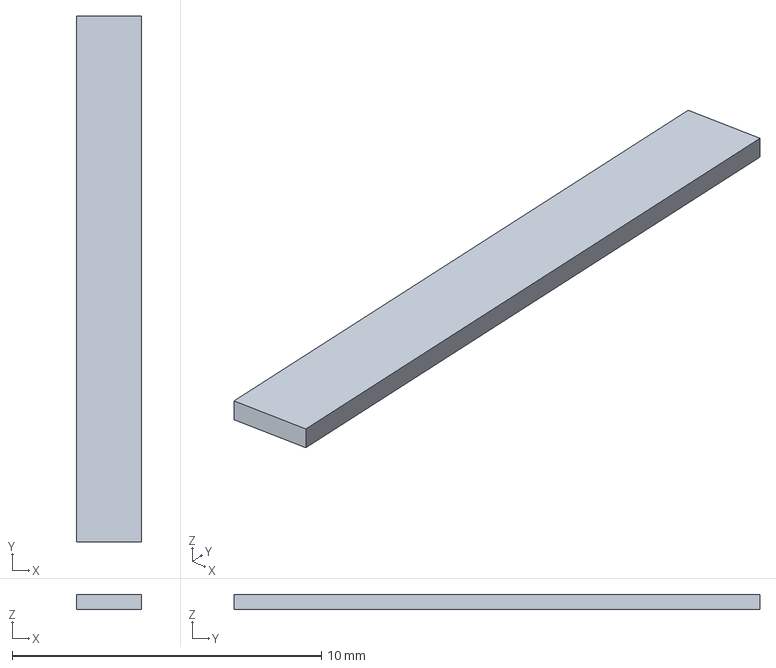
[picture p38: CAD file, 2026-10-19]
artifacts/plates/magenta.3mf
2.10 x 17.0 x 0.5 mm
