bprendie/weazlbook/artifacts/plates/oriented/01_coupons/ph_usb_cover.stl

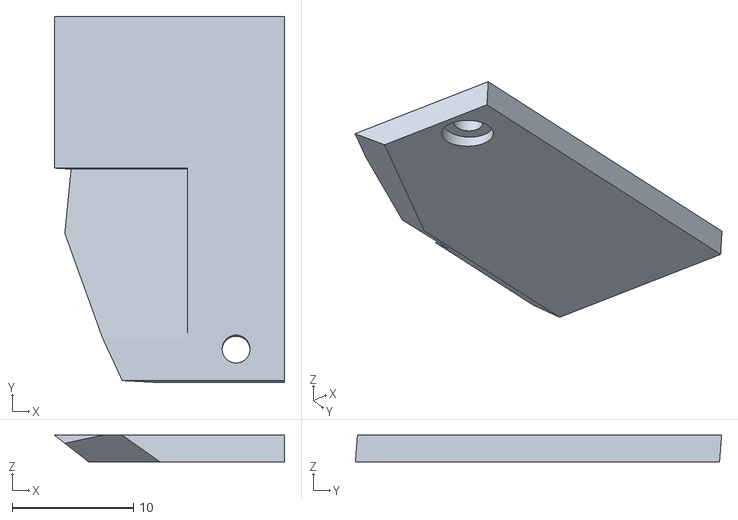
[picture p39: CAD file, 2026-10-19]
artifacts/plates/oriented/01_coupons/ph_usb_cover.stl
19.0 x 30.3 x 2.19
