bprendie/weazlbook/artifacts/plates/oriented/acid_green/shell.stl

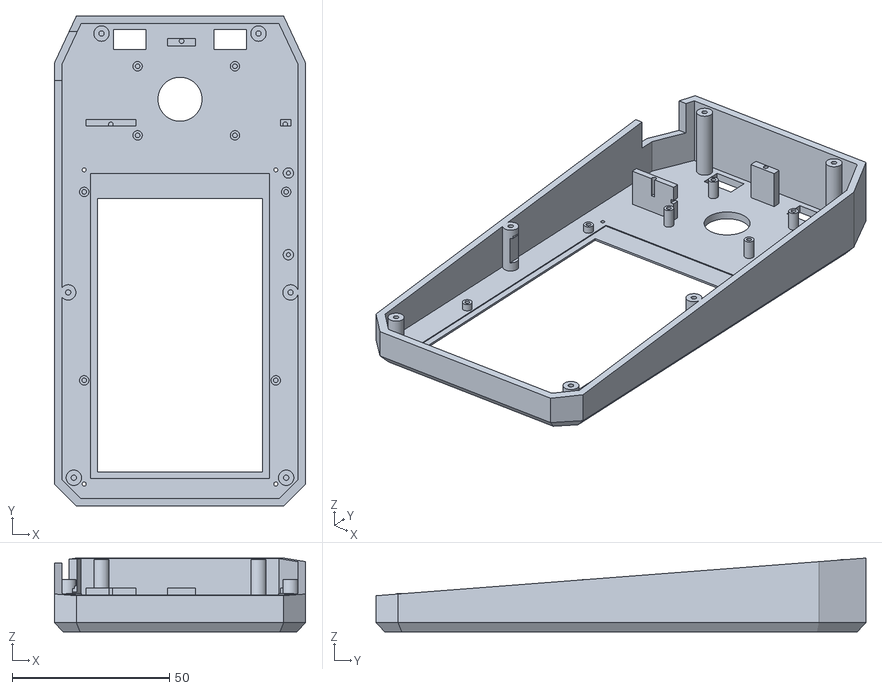
[picture p40: CAD file, 2026-10-19]
artifacts/plates/oriented/acid_green/shell.stl
80.0 x 156.0 x 23.5
