bprendie/weazlbook/artifacts/plates/oriented/black/nav_carrier.stl

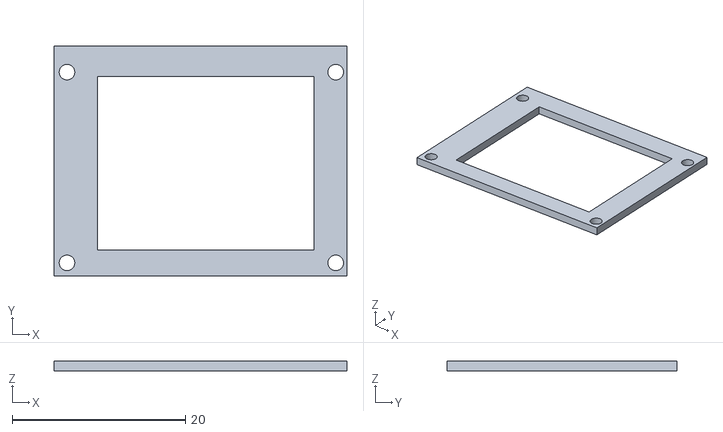
[picture p41: CAD file, 2026-10-19]
artifacts/plates/oriented/black/nav_carrier.stl
33.8 x 26.5 x 1.20
