bprendie/weazlbook/artifacts/plates/oriented/black_cover/service_cover.stl

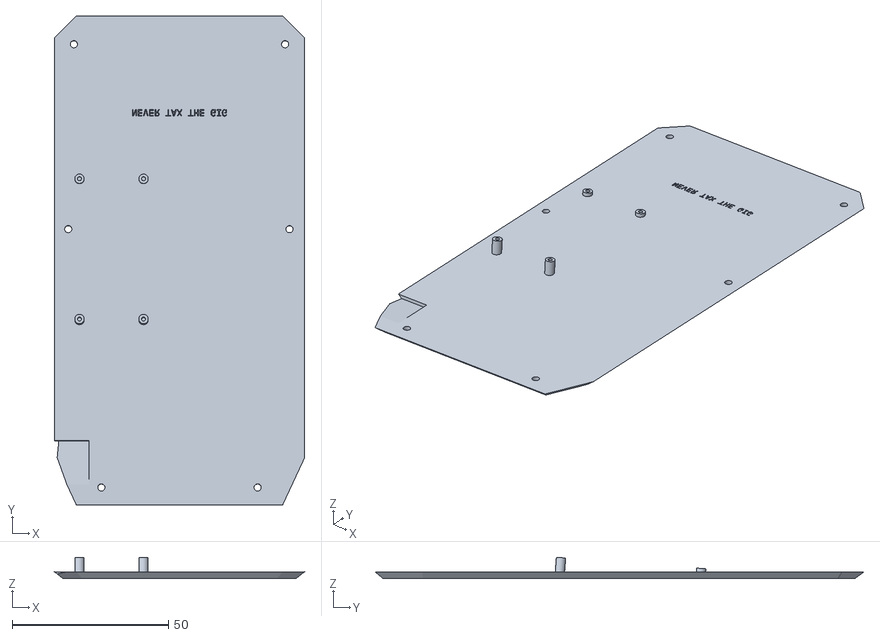
[picture p42: CAD file, 2026-10-19]
artifacts/plates/oriented/black_cover/service_cover.stl
80.0 x 156.5 x 6.86
