bprendie/weazlbook/artifacts/plates/oriented/cyan/cyan_insert.stl

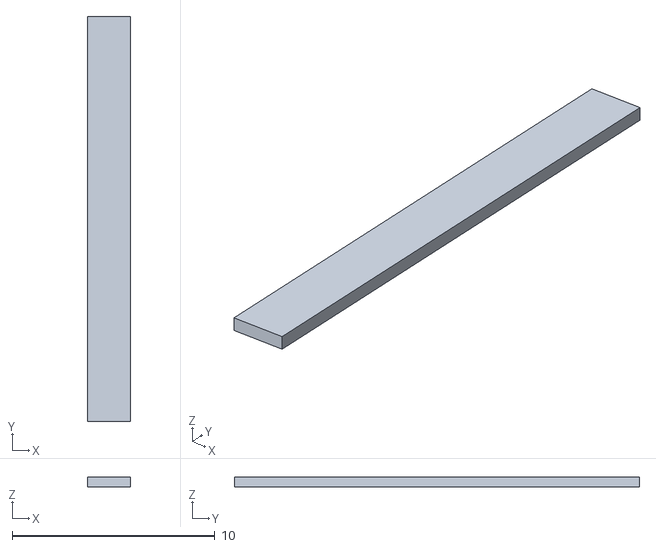
[picture p43: CAD file, 2026-10-19]
artifacts/plates/oriented/cyan/cyan_insert.stl
2.10 x 20.0 x 0.5
