bprendie/weazlbook/artifacts/plates/oriented/tpu_black/key_tpu_face.stl

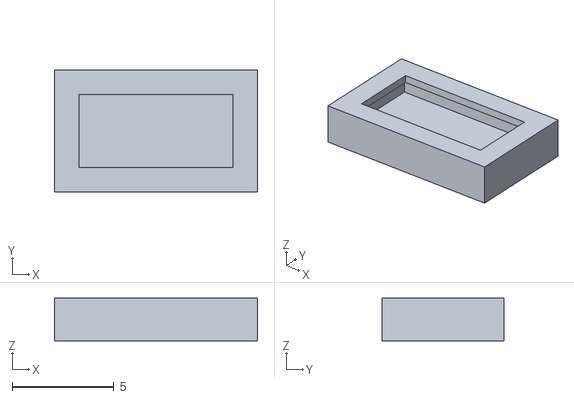
[picture p44: CAD file, 2026-10-19]
artifacts/plates/oriented/tpu_black/key_tpu_face.stl
10.0 x 6.00 x 2.10
