bprendie/weazlbook/artifacts/cad/coupons/ph_usb_cover.stl

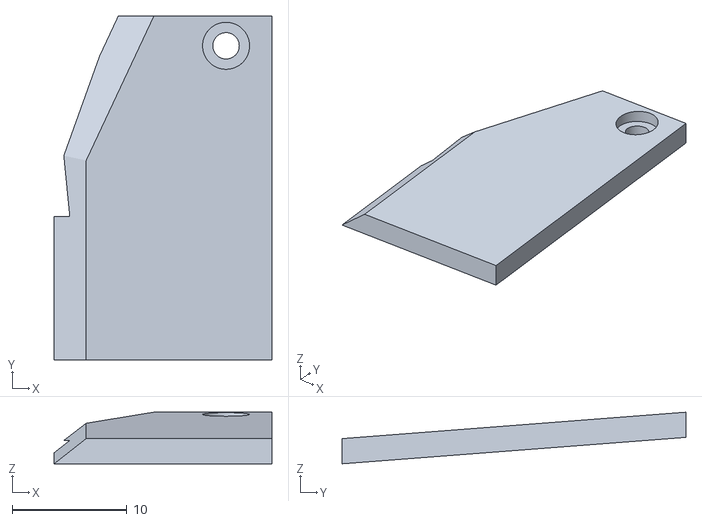
[picture p45: CAD file, 2026-10-19]
artifacts/cad/coupons/ph_usb_cover.stl
19.0 x 30.0 x 4.51
