bprendie/weazlbook/artifacts/plates/oriented/01_coupons/fpc_radius_2_assumption.stl

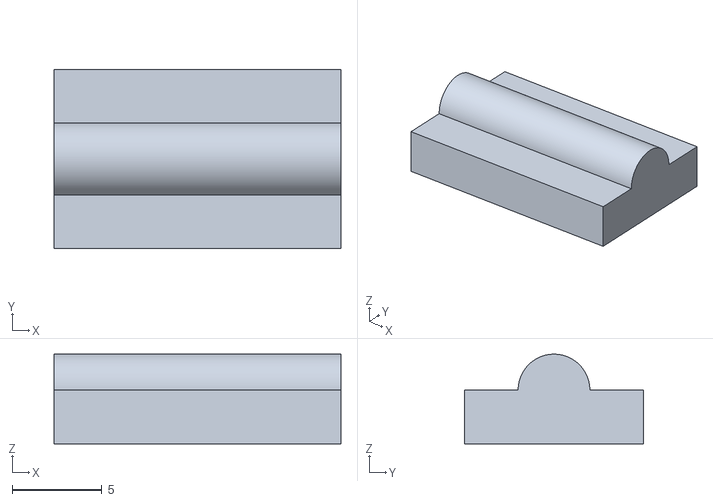
[picture p46: CAD file, 2026-10-19]
artifacts/plates/oriented/01_coupons/fpc_radius_2_assumption.stl
16.0 x 10.0 x 5.00
