bprendie/weazlbook/artifacts/plates/oriented/black/back_key.stl

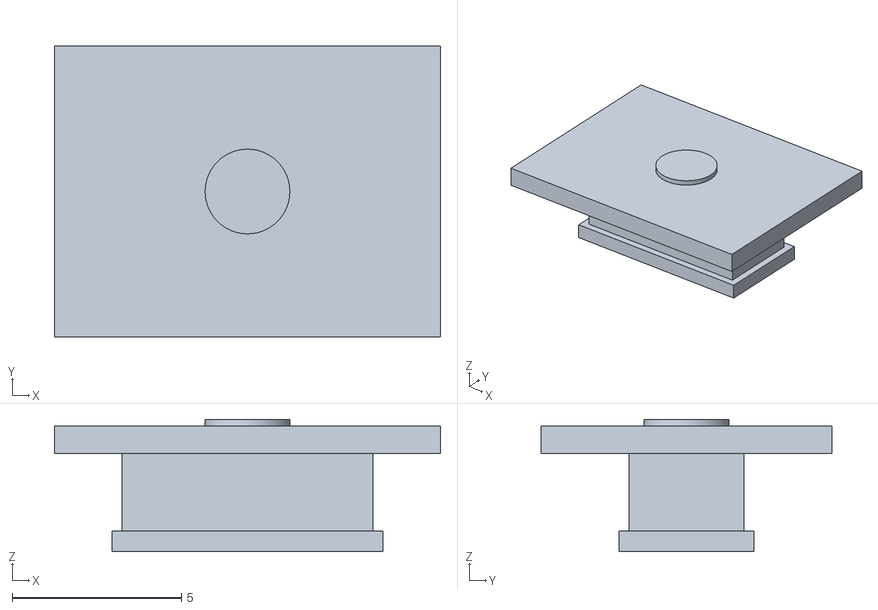
[picture p47: CAD file, 2026-10-19]
artifacts/plates/oriented/black/back_key.stl
11.4 x 8.60 x 3.90
