bprendie/weazlbook/artifacts/cad/coupons/pilot_1.5mm.stl

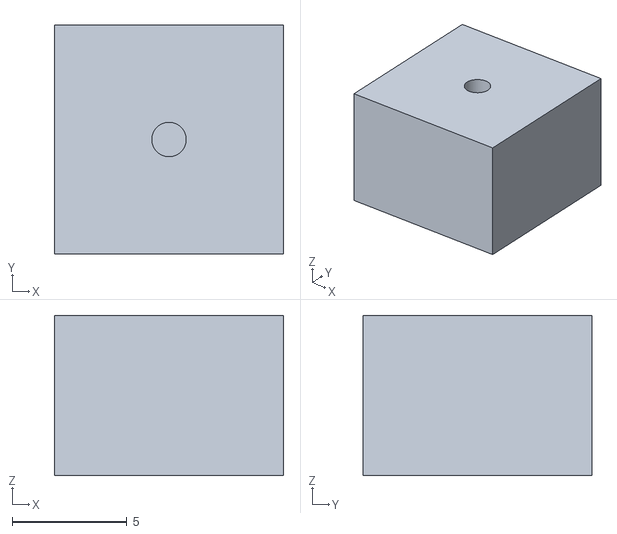
[picture p48: CAD file, 2026-10-19]
artifacts/cad/coupons/pilot_1.5mm.stl
10.0 x 10.0 x 7.00
