bprendie/weazlbook/artifacts/cad/step/magenta_insert.step

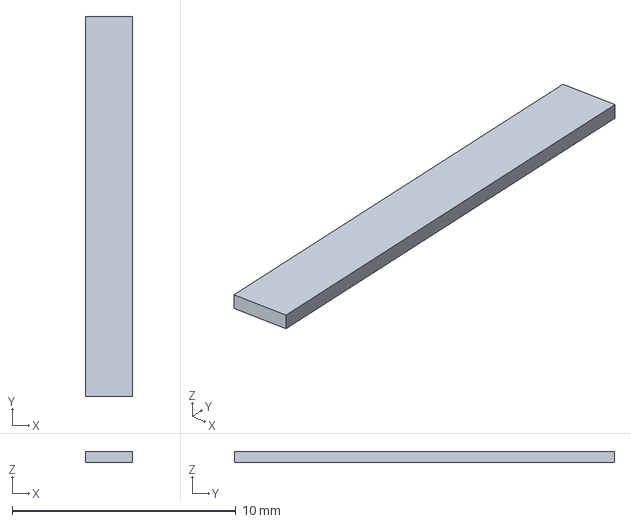
[picture p49: CAD file, 2026-10-19]
artifacts/cad/step/magenta_insert.step
2.10 x 17.0 x 0.5 mm
