bprendie/weazlbook/artifacts/plates/01_coupons.3mf

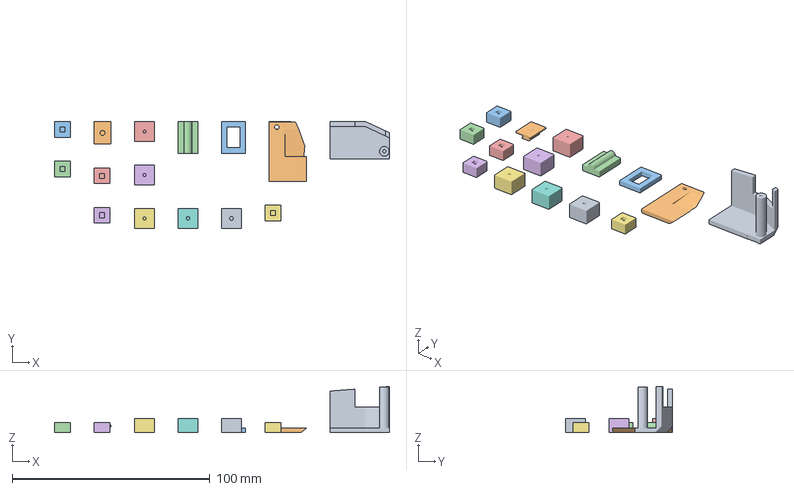
[picture p50: CAD file, 2026-10-19]
artifacts/plates/01_coupons.3mf
169.6 x 54.0 x 23.3 mm
ph_usb_wall.stl
ph_usb_cover.stl
key_guide.stl
fpc_radius_2_assumption.stl
pilot_1.5mm.stl
pilot_1.6mm.stl
pilot_1.7mm.stl
pilot_1.8mm.stl
pilot_1.9mm.stl
key_slider.stl
nav_square_2.45mm.stl
nav_square_2.50mm.stl
nav_square_2.55mm.stl
nav_square_2.60mm.stl
nav_square_2.65mm.stl
