bprendie/weazlbook/artifacts/plates/oriented/black/battery_tray.stl

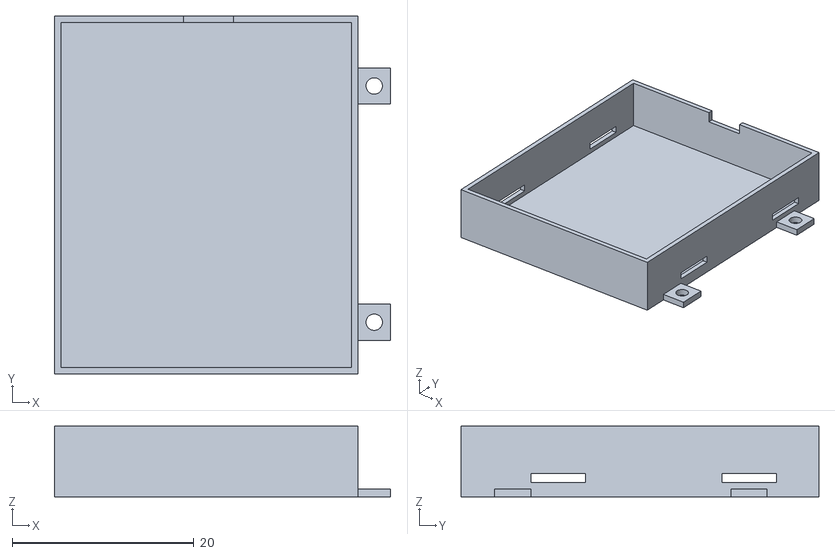
[picture p51: CAD file, 2026-10-19]
artifacts/plates/oriented/black/battery_tray.stl
37.0 x 39.4 x 7.80
