bprendie/weazlbook/artifacts/cad/step/bezel.step

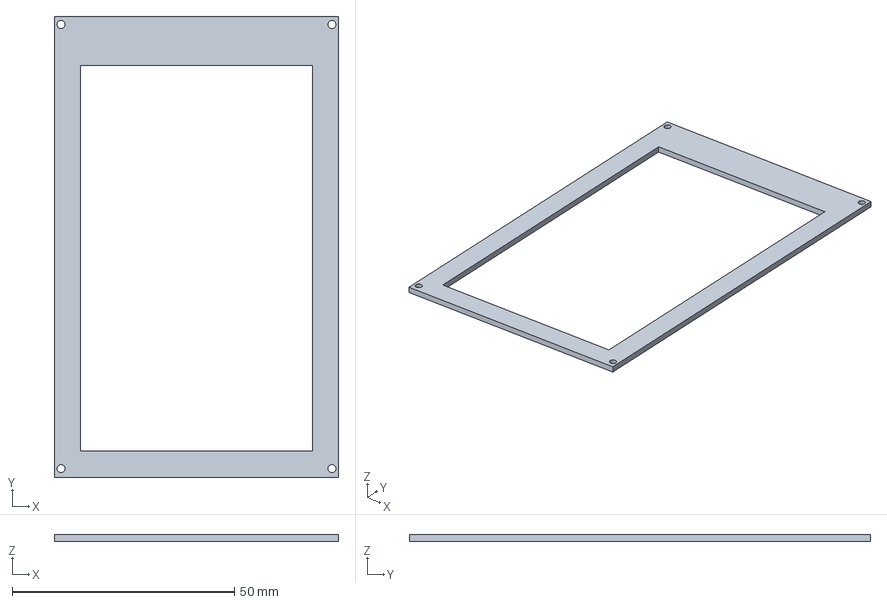
[picture p52: CAD file, 2026-10-19]
artifacts/cad/step/bezel.step
64.0 x 103.8 x 1.50 mm
