bprendie/weazlbook/artifacts/plates/black.3mf

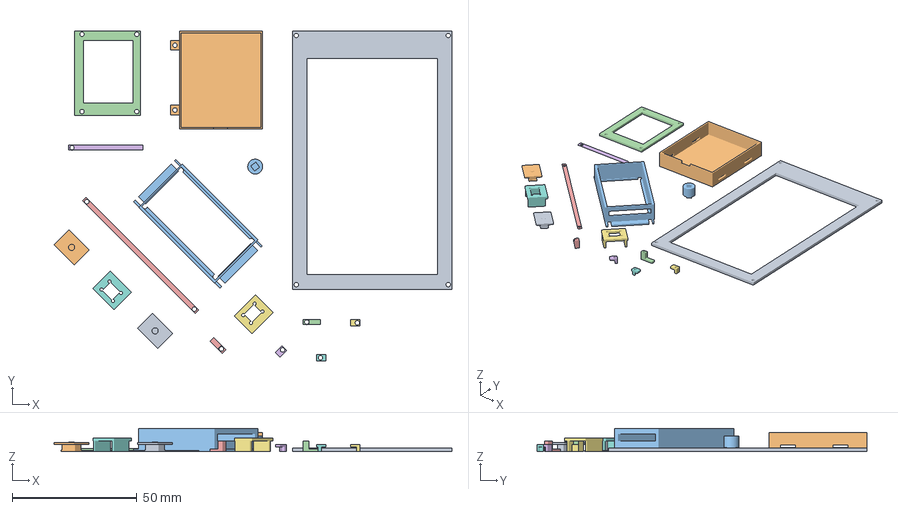
[picture p53: CAD file, 2026-10-19]
artifacts/plates/black.3mf
159.7 x 132.4 x 9.40 mm
bezel.stl
battery_tray.stl
driver_carrier_adjustable.stl
nav_carrier.stl
display_bridge_0.stl
display_bridge_1.stl
back_carrier.stl
mark_carrier.stl
back_key.stl
mark_key.stl
cap_adapter_provisional.stl
nav_retainer_0.stl
nav_retainer_1.stl
mainboard_clamp_1.stl
mainboard_clamp_0.stl
mainboard_clamp_2.stl
