bprendie/weazlbook/artifacts/plates/oriented/01_coupons/pilot_1.9mm.stl

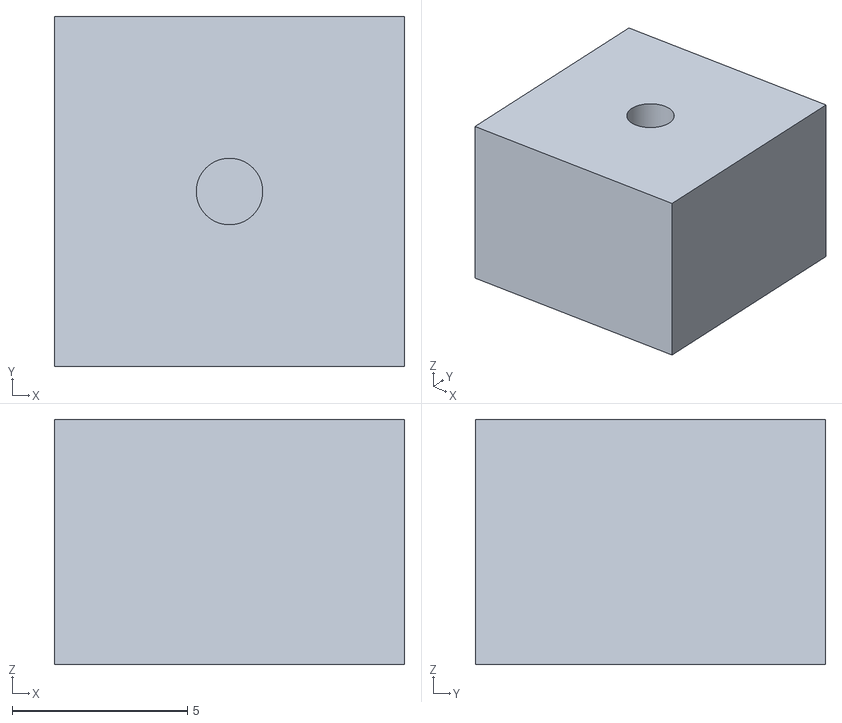
[picture p54: CAD file, 2026-10-19]
artifacts/plates/oriented/01_coupons/pilot_1.9mm.stl
10.0 x 10.0 x 7.00
