bprendie/weazlbook/artifacts/cad/step/back_carrier.step

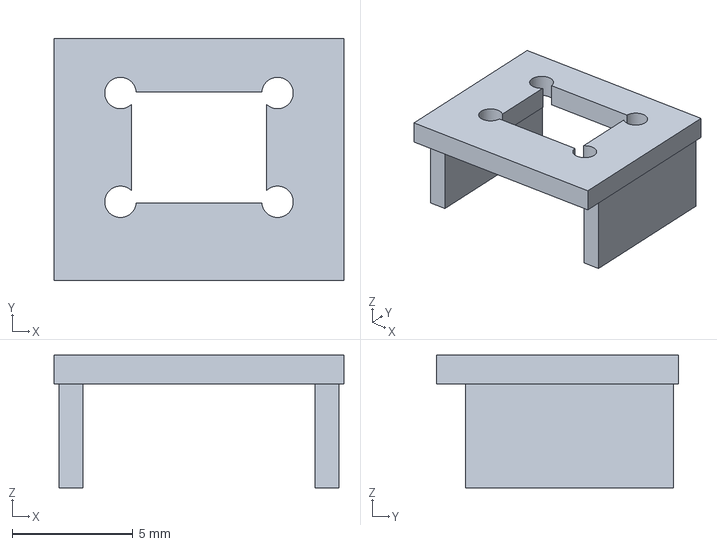
[picture p55: CAD file, 2026-10-19]
artifacts/cad/step/back_carrier.step
12.0 x 10.0 x 5.50 mm
