bprendie/weazlbook/artifacts/plates/oriented/01_coupons/ph_usb_wall.stl

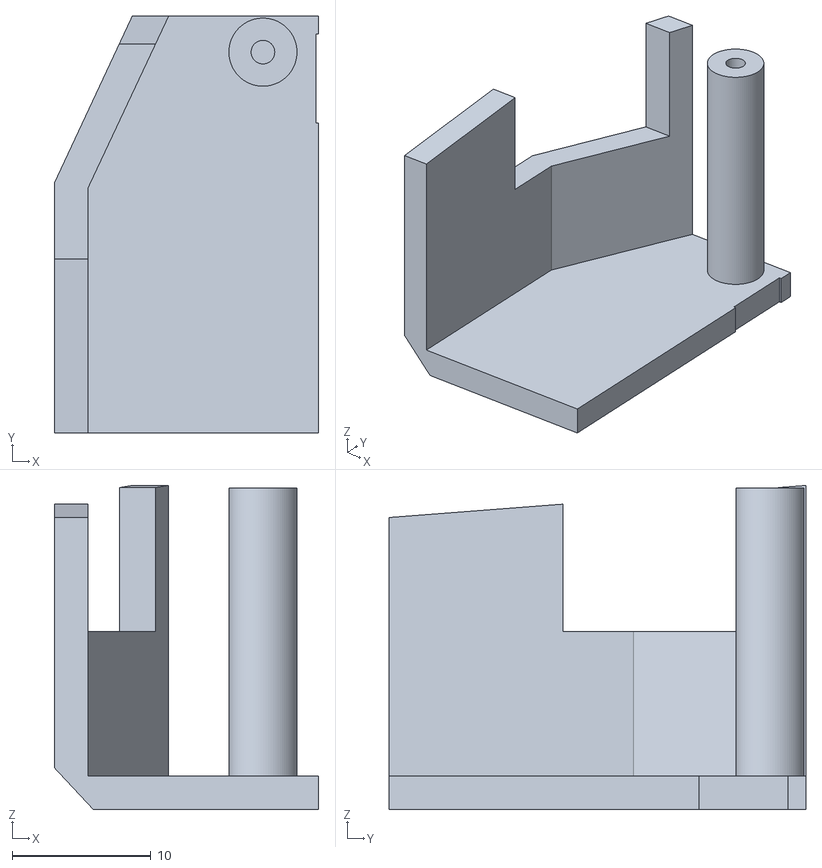
[picture p56: CAD file, 2026-10-19]
artifacts/plates/oriented/01_coupons/ph_usb_wall.stl
19.0 x 30.0 x 23.3
