bprendie/weazlbook/artifacts/plates/oriented/black/display_bridge_0.stl

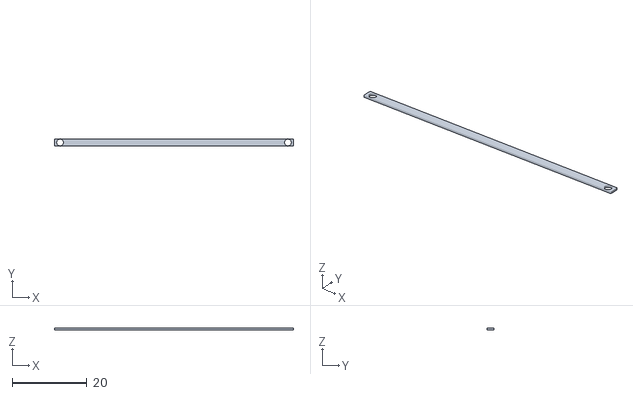
[picture p57: CAD file, 2026-10-19]
artifacts/plates/oriented/black/display_bridge_0.stl
64.0 x 2.00 x 0.5
