bprendie/weazlbook/artifacts/plates/tpu_black.3mf

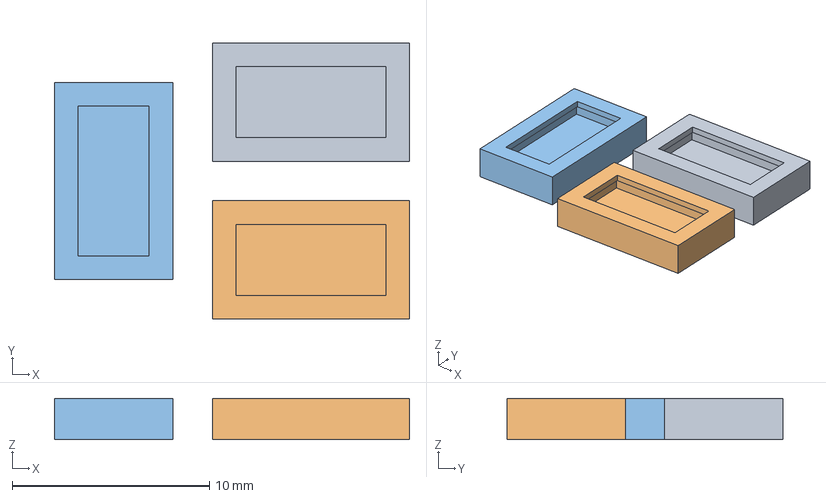
[picture p58: CAD file, 2026-10-19]
artifacts/plates/tpu_black.3mf
18.0 x 14.0 x 2.10 mm
back_tpu_face.stl
mark_tpu_face.stl
key_tpu_face.stl
