bprendie/weazlbook/artifacts/cad/coupons/key_guide.stl

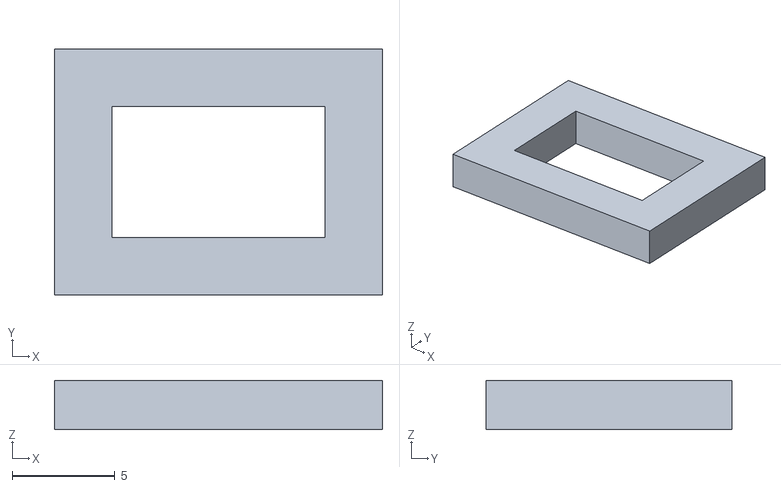
[picture p59: CAD file, 2026-10-19]
artifacts/cad/coupons/key_guide.stl
16.0 x 12.0 x 2.40
