bprendie/weazlbook/artifacts/cad/step/driver_carrier_adjustable.step

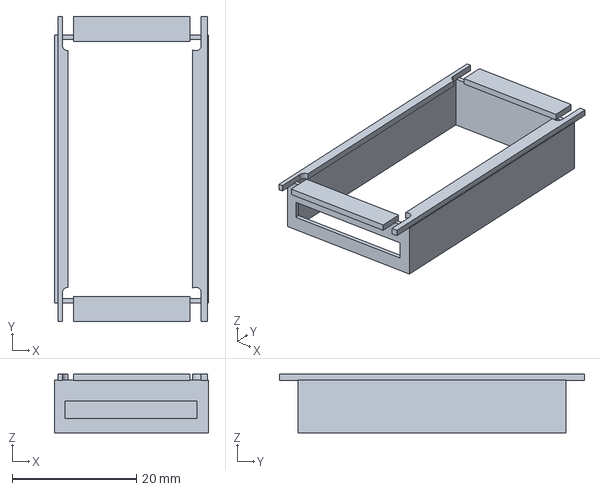
[picture p60: CAD file, 2026-10-19]
artifacts/cad/step/driver_carrier_adjustable.step
24.8 x 49.0 x 9.40 mm
