bprendie/weazlbook/artifacts/plates/oriented/black/nav_retainer_1.stl

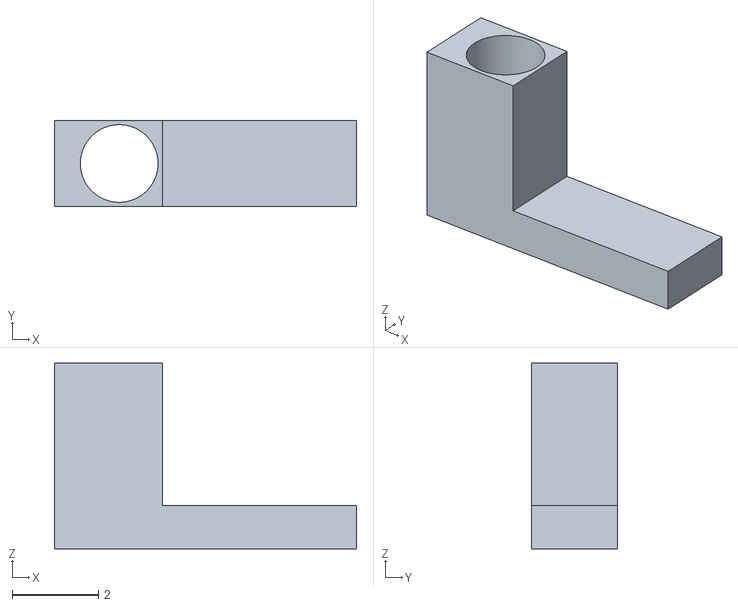
[picture p61: CAD file, 2026-10-19]
artifacts/plates/oriented/black/nav_retainer_1.stl
7.00 x 2.00 x 4.30
