bprendie/weazlbook/artifacts/cad/step/service_cover.step

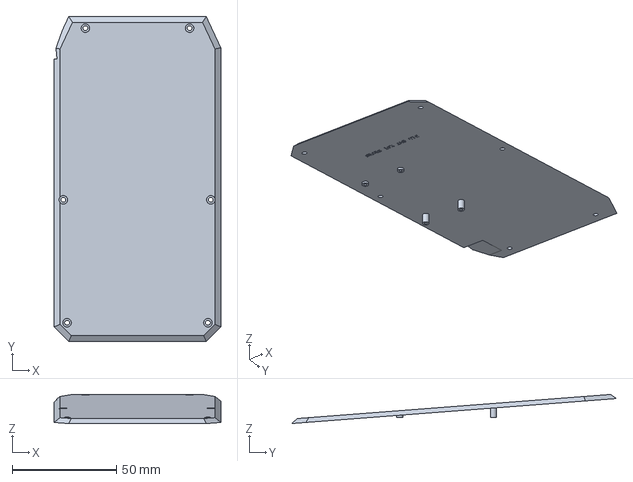
[picture p62: CAD file, 2026-10-19]
artifacts/cad/step/service_cover.step
80.0 x 156.0 x 14.0 mm
