bprendie/weazlbook/artifacts/plates/oriented/black/display_bridge_1.stl

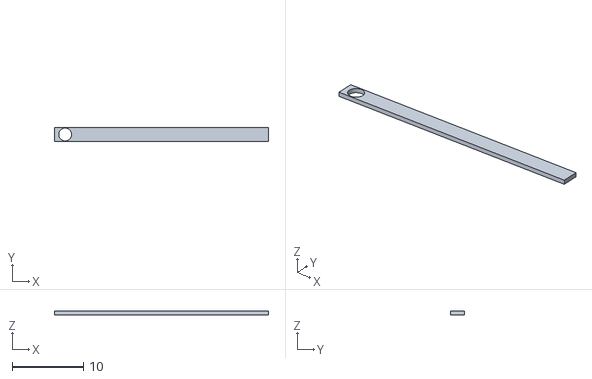
[picture p63: CAD file, 2026-10-19]
artifacts/plates/oriented/black/display_bridge_1.stl
30.0 x 2.00 x 0.5
