bprendie/weazlbook/(list of files, cad)

Other CAD files:
artifacts/plates/oriented/black/mainboard_clamp_0.stl
artifacts/plates/oriented/black/mainboard_clamp_1.stl
artifacts/plates/oriented/black/mainboard_clamp_2.stl
artifacts/cad/step/mainboard_clamp_0.step
artifacts/plates/oriented/magenta/magenta_insert.stl
artifacts/plates/black_cover.3mf
artifacts/plates/oriented/tpu_black/back_tpu_face.stl
artifacts/plates/oriented/01_coupons/pilot_1.7mm.stl
artifacts/plates/oriented/tpu_black/mark_tpu_face.stl
artifacts/cad/coupons/nav_square_2.45mm.stl
artifacts/cad/coupons/pilot_1.8mm.stl
artifacts/cad/coupons/fpc_radius_2_assumption.stl
artifacts/plates/cyan.3mf
artifacts/plates/oriented/01_coupons/pilot_1.6mm.stl
artifacts/plates/acid_green.3mf
artifacts/plates/oriented/01_coupons/pilot_1.8mm.stl
artifacts/cad/coupons/pilot_1.9mm.stl
artifacts/cad/step/mark_key.step
artifacts/plates/oriented/01_coupons/nav_square_2.50mm.stl
artifacts/plates/oriented/black/mark_key.stl
artifacts/cad/coupons/nav_square_2.60mm.stl
artifacts/plates/oriented/01_coupons/nav_square_2.60mm.stl
artifacts/cad/coupons/key_slider.stl
artifacts/cad/step/back_tpu_face.step
artifacts/plates/oriented/01_coupons/nav_square_2.55mm.stl
artifacts/cad/coupons/pilot_1.7mm.stl
artifacts/cad/step/shell.step
artifacts/plates/oriented/01_coupons/nav_square_2.65mm.stl
artifacts/plates/oriented/black/nav_retainer_0.stl
artifacts/cad/coupons/pilot_1.6mm.stl
artifacts/cad/step/display_bridge_1.step
artifacts/plates/oriented/01_coupons/key_guide.stl
artifacts/plates/oriented/black/back_carrier.stl
artifacts/cad/coupons/ph_usb_wall.stl
artifacts/cad/step/mark_carrier.step
artifacts/plates/oriented/01_coupons/key_slider.stl
artifacts/plates/oriented/black/mark_carrier.stl
artifacts/cad/coupons/key_tpu_face.stl
artifacts/cad/step/display_bridge_0.step
artifacts/plates/oriented/01_coupons/pilot_1.5mm.stl
artifacts/plates/oriented/black/driver_carrier_adjustable.stl
artifacts/cad/coupons/nav_square_2.50mm.stl
artifacts/cad/step/nav_retainer_1.step
artifacts/plates/oriented/01_coupons/nav_square_2.45mm.stl
artifacts/plates/oriented/black/cap_adapter_provisional.stl
artifacts/cad/coupons/nav_square_2.65mm.stl
artifacts/plates/oriented/black/bezel.stl
artifacts/cad/step/mark_tpu_face.step
artifacts/cad/step/cyan_insert.step
artifacts/cad/step/nav_carrier.step
artifacts/cad/step/battery_tray.step
artifacts/cad/step/back_key.step
artifacts/cad/step/nav_retainer_0.step
artifacts/cad/stl/back_carrier.stl
artifacts/cad/stl/back_key.stl
artifacts/cad/stl/back_tpu_face.stl
artifacts/cad/stl/battery_tray.stl
artifacts/cad/stl/bezel.stl
artifacts/cad/stl/cap_adapter_provisional.stl
artifacts/cad/stl/cyan_insert.stl
artifacts/cad/stl/display_bridge_0.stl
artifacts/cad/stl/display_bridge_1.stl
artifacts/cad/stl/driver_carrier_adjustable.stl
artifacts/cad/stl/magenta_insert.stl
artifacts/cad/stl/mainboard_clamp_0.stl
artifacts/cad/stl/mainboard_clamp_1.stl
artifacts/cad/stl/mainboard_clamp_2.stl
artifacts/cad/stl/mark_carrier.stl
artifacts/cad/stl/mark_key.stl
artifacts/cad/stl/mark_tpu_face.stl
artifacts/cad/stl/nav_carrier.stl
artifacts/cad/stl/nav_retainer_0.stl
artifacts/cad/stl/nav_retainer_1.stl
artifacts/cad/stl/service_cover.stl
artifacts/cad/stl/shell.stl
