bprendie/weazlbook/baseline/weazlbook_mockup_r04/render/assembled.png

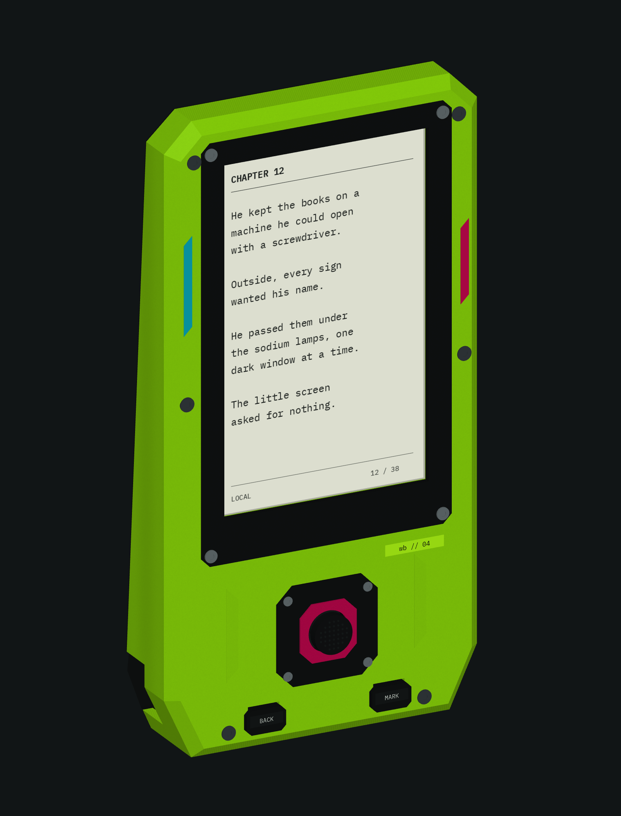
baseline/weazlbook_mockup_r04/render/assembled.png
