bprendie/weazlbook/evidence/device-browser-tests.txt

PASS: menu, settings, codes, About, lock API enforcement, reload, immediate duress, safe reset, hold MARK, READ, mobile
